JustinVerkade/KiCadLibraryProcessor/BOM_Processor/20240322-Electrical component library.xlsx

Document: | Electrical component library
Last changed: | 2024-03-23
Author: | Justin Verkade
Type | Manufacturer number | Manufacturer | Footprint | Val1 | Val2 | Val3 | Val4 | Val5 | Val6 | Costs | Url
Resistor | CRCW04022K20JNED | Vishay / Dale | 0402 | 2.2k | 5% | 50V | 62.5mW |  |  | €0.09 | https://nl.mouser.com/ProductDetail/Vishay-Dale/CRCW04022K20JNED?qs=hD42E%2F8yzjr994JNQ8Enjw%3D%3D
Capacitor | 04026C104KAT2A | KYOCERA AVX | 0402 | 100n | 10% | 6.3V |  |  |  | €0.09 | https://nl.mouser.com/ProductDetail/KYOCERA-AVX/04026C104KAT2A?qs=Q0wCMCRSJ1vLqipDGm0h%252BA%3D%3D
Microcontroller | STM32F072CBT6 | STMicroelectronics | LQFP-48 | 48Mhz | 128kB | 16kB |  |  |  | €4.19 | https://nl.mouser.com/ProductDetail/STMicroelectronics/STM32F072CBT6?qs=xf9JV0PLFEfBqXx8wKtR8A%3D%3D
Motor driver | TMC6300-LA | Trinamics ADI | QFN-20 | BLDC | 2A | 11V |  |  |  | €2.26 | https://nl.mouser.com/ProductDetail/ADI-Trinamic/TMC6300-LA-T?qs=TiOZkKH1s2SPDan6zA6fKg%3D%3D
Microcontroller | STM32L431KBU6 | STMicroelectronics | UFQFPN-32 | 80Mhz | 128kB | 64kB |  |  |  | €4.56 | https://nl.mouser.com/ProductDetail/STMicroelectronics/STM32L431KBU6?qs=U58vgkJzipSSkpDs8ltE9g%3D%3D
ESD/TVS diode | SZESD8351P2T5G | Onsemi | SOD-923-2 | 3.3V |  |  |  |  |  | €0.36 | https://nl.mouser.com/ProductDetail/onsemi/SZESD8351P2T5G?qs=dbuNSGnowt0hk7yUFmffJA%3D%3D
LED | 150060AS75000 | Wurth Electronik | 0603 | Amber | 30mA | 2V |  |  |  | €0.14 | https://nl.mouser.com/ProductDetail/Wurth-Elektronik/150060AS75000?qs=d0WKAl%252BL4KbvMBYryeof0Q%3D%3D
ESD/TVS diode | ESD9X12ST5G | Onsemi | SOD-923-2 | 12V |  |  |  |  |  | €0.20 | https://nl.mouser.com/ProductDetail/onsemi/ESD9X12ST5G?qs=OSf9jACorvYeEtLjAfCdrQ%3D%3D
Buck converter | MP1479GTF-Z | MPS | SOT-563-6 | 800mV-10V | 1A | 18V |  |  |  | €0.90 | https://nl.mouser.com/ProductDetail/Monolithic-Power-Systems-MPS/MP1479GTF-Z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
Connector | B8B-PH-K-S_LF__SN_ | JST | - | 8-pin | 2mm | 3A |  |  |  | €0.40 | https://nl.rs-online.com/web/p/pcb-headers/8201444
Connector | B3B-PH-K-S_LF__SN_ | JST | - | 3-pin | 2mm | 3A |  |  |  | €0.05 | https://nl.rs-online.com/web/p/pcb-headers/8201431
Connector | B2B-PH-K-S_LF__SN_ | JST | - | 2-pin | 2mm | 3A |  |  |  | €0.16 | https://nl.rs-online.com/web/p/pcb-headers/8201422
Resistor | ERJ-6DSFR12V | Panasonic | 0805 | 120m | 1% |  | 500mW |  |  | €0.42 | https://nl.mouser.com/ProductDetail/Panasonic/ERJ-6DSFR12V?qs=WO7YBshssFF0LlAZA3Tj0Q%3D%3D
Ferrite bead | BLM15AX102SZ1D | Murata Electronics | 0402 | 1k | 25% | 350mA |  |  |  | €0.09 | https://nl.mouser.com/ProductDetail/Murata-Electronics/BLM15AX102SZ1D?qs=lEfY3O89Aqnho9IqRYLNSw%3D%3D
Connector | 20021121-00006T4LF | Amphenol FCI | - | 6-pin | 1.27mm | 1A |  |  |  | €0.57 | https://nl.mouser.com/ProductDetail/Amphenol-FCI/20021121-00006T4LF?qs=oJs1R%252BxK6kTRYpFukouk8Q%3D%3D
Opamp | TLV8541DBVR | Texas Instruments | SOT-23-5 | 3.6V |  |  |  |  |  | €0.84 | https://nl.mouser.com/ProductDetail/Texas-Instruments/TLV8541DBVR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
Inductor | VLS3015CX-4R7M-1 | TDK | 3x3x1.5mm | 4.7u | 1.52A |  |  |  |  | €0.31 | https://nl.mouser.com/ProductDetail/TDK/VLS3015CX-4R7M-1?qs=gZXFycFWdANzf31QH9GBWA%3D%3D
ESD/TVS diode | PTVS12VS1UR,115 | Nexperia | SOD-123-2 | 12V |  |  |  |  |  | €0.35 | https://nl.mouser.com/ProductDetail/Nexperia/PTVS12VS1UR115?qs=LMSg3oBIm%2FiWSHvsyxWiLg%3D%3D
ESD/TVS diode | SZESD9101P2T5G | Onsemi | SOD-923-2 | 5V |  |  |  |  |  | €0.43 | https://nl.mouser.com/ProductDetail/onsemi/SZESD9101P2T5G?qs=5aG0NVq1C4yTUV3vL3eSQg%3D%3D
Capacitor | C1005X7R1C104K050BC | TDK | 0402 | 100n | 10% | 12V |  |  |  | €0.09 | https://nl.mouser.com/ProductDetail/TDK/C1005X7R1C104K050BC?qs=NRhsANhppD%252BhAGOapA8QKQ%3D%3D
Capacitor | CL21A226MAYNNNE | Samsung Electro-Mechanics | 0805 | 22u | 20% | 25V |  |  |  | €0.23 | https://nl.mouser.com/ProductDetail/Samsung-Electro-Mechanics/CL21A226MAYNNNE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
Capacitor | TMK107BJ105KA-T | TAIYO YUDEN | 0603 | 1u | 10% | 25V |  |  |  | €0.09 | https://nl.mouser.com/ProductDetail/TAIYO-YUDEN/TMK107BJ105KA-T?qs=PzICbMaShUeN5muIUMy52A%3D%3D
Capacitor | GRM21BC71E106KE01K | Murata Electronics | 0805 | 10u | 10% | 25V |  |  |  | €0.34 | https://nl.mouser.com/ProductDetail/Murata-Electronics/GRM21BC71E106KE01K?qs=By6Nw2ByBD2m3JOqf4AY1Q%3D%3D
Capacitor | CL10A225KO8NNNC | Samsung Electro-Mechanics | 0603 | 2.2u | 10% | 16V |  |  |  | €0.09 | https://nl.mouser.com/ProductDetail/Samsung-Electro-Mechanics/CL10A225KO8NNNC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
Capacitor | GRM155C81E105KE11J | Murata Electronics | 0402 | 1u | 10% | 25V |  |  |  | €0.09 | https://nl.mouser.com/ProductDetail/Murata-Electronics/GRM155C81E105KE11J?qs=hNud%2FORuBR0msnbqee6%2FPw%3D%3D
Resistor | AF0402JR-07220RL | YAGEO | 0402 | 220 | 5% | 50V | 62.5mW |  |  | €0.09 | https://nl.mouser.com/ProductDetail/YAGEO/AF0402JR-07220RL?qs=Ghq3E7L6HNfV8BjGdjwaqw%3D%3D
Resistor | RC0402FR-072K2P | YAGEO | 0402 | 2.2k | 1% | 50V | 62.5mW |  |  | €0.09 | https://nl.mouser.com/ProductDetail/YAGEO/RC0402FR-072K2P?qs=oypCK0zG3263%2FFJJTa4fIg%3D%3D
Resistor | RC0402FR-7D100KL | YAGEO | 0402 | 100k | 1% | 50V | 62.5mW |  |  | €0.09 | https://nl.mouser.com/ProductDetail/YAGEO/RC0402FR-7D100KL?qs=F5EMLAvA7IBe5AeajP0LKQ%3D%3D
Resistor | RC0402FR-0713KL | YAGEO | 0402 | 13k | 1% | 50V | 62.5mW |  |  | €0.09 | https://nl.mouser.com/ProductDetail/YAGEO/RC0402FR-0713KL?qs=sxZXDnvRBEhPjc%252B9C6HVrA%3D%3D
Resistor | RC0402FR-0740K2L | YAGEO | 0402 | 40.2k | 1% | 50V | 62.5mW |  |  | €0.09 | https://nl.mouser.com/ProductDetail/YAGEO/RC0402FR-0740K2L?qs=UOUeRUa%252B8Wn56bwc3oChog%3D%3D
Resistor | RC0402FR-077K68L | YAGEO | 0402 | 7.68k | 1% | 50V | 62.5mW |  |  | €0.09 | https://nl.mouser.com/ProductDetail/YAGEO/RC0402FR-077K68L?qs=Is6ZsIPfHkasmjGY7J9QlA%3D%3D
Resistor | AC0402FR-7W47KL | YAGEO | 0402 | 47k | 1% | 50V | 125mW |  |  | €0.09 | https://nl.mouser.com/ProductDetail/YAGEO/AC0402FR-7W47KL?qs=mQk0km4IMDeu%252BLYkO5whnw%3D%3D
Resistor | RC0402JR-0710RP | YAGEO | 0402 | 10 | 5% | 50V | 62.5mW |  |  | €0.09 | https://nl.mouser.com/ProductDetail/YAGEO/RC0402JR-0710RP?qs=oypCK0zG324s%252BbbL7ccvUA%3D%3D
Resistor | RT0402FRE07649RL | YAGEO | 0402 | 649 | 1% | 50V | 62.5mW |  |  | €0.11 | https://nl.mouser.com/ProductDetail/YAGEO/RT0402FRE07649RL?qs=sGAEpiMZZMvdGkrng054t98Xz4DA4UW4bL7f7IZrCXc%3D
Resistor | ERJ-2RKF2702X | Panasonic | 0402 | 27k | 1% | 50V | 100mW |  |  | €0.09 | https://nl.mouser.com/ProductDetail/Panasonic/ERJ-2RKF2702X?qs=YMBIwoNQYdVjy3UL%2FjeFIg%3D%3D
Capacitor | C0603C225K9PAC | KEMET | 0603 | 2.2u | 10% | 6.3V |  |  |  | €0.09 | https://nl.mouser.com/ProductDetail/KEMET/C0603C225K9PAC?qs=AHS6Mz2dKxMbzMnN5xHEwA%3D%3D
LED | 150060SS55040 | Wurth Electronik | 0603 | Super Red | 20mA | 2V |  |  |  | €0.18 | https://nl.mouser.com/ProductDetail/Wurth-Elektronik/150060SS55040?qs=8Aam6%252B7C6HG0AGgMR5PhFg%3D%3D
LED | 150060VS55040 | Wurth Electronik | 0603 | Green | 20mA | 2V |  |  |  | €0.18 | https://nl.mouser.com/ProductDetail/Wurth-Elektronik/150060VS55040?qs=8Aam6%252B7C6HEumg%252B0cJZzvA%3D%3D
Capacitor | 04026A100JAT2A | KYOCERA AVX | 0402 | 10p | 5% | 6.3V |  |  |  | €0.24 | https://nl.mouser.com/ProductDetail/KYOCERA-AVX/04026A100JAT2A?qs=XLNwXgtzMM%2Fx5CgSRtM7uA%3D%3D
Connector | 284512-3 | TE Connectivity | - | 3-pin | 3.5mm | 11A |  |  |  | €1.15 | https://nl.mouser.com/ProductDetail/TE-Connectivity/284512-3?qs=woBvfblj%2Fzwah7g8QvojCQ%3D%3D
Ferrite bead | MMZ2012D121BTD25 | TDK | 0805 | 120 | 25% | 500mA |  |  |  | €0.10 | https://nl.mouser.com/ProductDetail/TDK/MMZ2012D121BTD25?qs=pvNC7ksEVIfZfSRHo03SKw%3D%3D
ESD/TVS diode | PESD2USB3UVT-QR | Nexperia | SOT-23-3 | 3.3V |  |  |  |  |  | €0.35 | https://nl.mouser.com/ProductDetail/Nexperia/PESD2USB3UVT-QR?qs=3Rah4i%252BhyCFPJOQFghMZ%252BQ%3D%3D
Resistor | AF0402FR-07120RL | YAGEO | 0402 | 120 | 1% | 50V | 62.5mW |  |  | €0.09 | https://nl.mouser.com/ProductDetail/YAGEO/AF0402FR-07120RL?qs=tggtontpCXNqJs0%252BaiMQVA%3D%3D
Resistor | AC0402JR-7W1KL | YAGEO | 0402 | 1k | 5% | 50V | 125mW |  |  | €0.09 | https://nl.mouser.com/ProductDetail/YAGEO/AC0402JR-7W1KL?qs=j%252B1pi9TdxUZ8VnEUd7zFaA%3D%3D
ESD/TVS diode | PEC33712C2AR1000 | Panjit | SOT-23-3 | 12V/-7V |  |  |  |  |  | €0.33 | https://nl.mouser.com/ProductDetail/Panjit/PEC33712C2A_R1_00001?qs=sPbYRqrBIVk%252Bwt1QuorMhw%3D%3D
Eeprom | AT24C02D-STUM-T | Microchip Technology | SOT-23-5 | 2kBit | I2C | 3.6V |  |  |  | €0.19 | https://nl.mouser.com/ProductDetail/Microchip-Technology/AT24C02D-STUM-T?qs=l5F7KFZg3O4Jn%2FWWCVhgNg%3D%3D
Capacitor | GRT155R71C104KE01J | Murata Electronics | 0402 | 100n | 10% | 16V |  |  |  | €0.09 | https://nl.mouser.com/ProductDetail/Murata-Electronics/GRT155R71C104KE01J?qs=RcG8xmE7yp2lWPzmRVbOdg%3D%3D
Resistor | CRCW040210K0JNEDC | Vishay / Dale | 0402 | 10k | 5% | 50V | 62.5mW |  |  | €0.09 | https://nl.mouser.com/ProductDetail/Vishay-Dale/CRCW040210K0JNEDC?qs=E3Y5ESvWgWMUjeDciQkbxw%3D%3D
Capacitor | 865230543003 | Wurth Electronik | ALU | 22u | 20% | 35V |  |  |  | €0.27 | https://nl.mouser.com/ProductDetail/Wurth-Elektronik/865230543003?qs=0KOYDY2FL29wTbOMyWRiVg%3D%3D
Resistor | RC0402FR-7D22RL | YAGEO | 0402 | 22 | 1% | 50V | 62.5mW |  |  | €0.09 | https://nl.mouser.com/ProductDetail/YAGEO/RC0402FR-7D22RL?qs=F5EMLAvA7ICmyszJ%252B2F6BQ%3D%3D
Resistor | CR0402-JW-470GLF | Bourns | 0402 | 47 | 5% | 50V | 62.5mW |  |  | €0.09 | https://nl.mouser.com/ProductDetail/Bourns/CR0402-JW-470GLF?qs=SUIU1o4JoRquVq%252BbfEL1Yg%3D%3D
Capacitor | CL10A105KO8NNWC | Samsung Electro-Mechanics | 0603 | 1u | 10% | 16V |  |  |  | €0.09 | https://nl.mouser.com/ProductDetail/Samsung-Electro-Mechanics/CL10A105KO8NNWC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
Fuse | 1206L025YR | Littlefuse | 1206 | 250mA | 16V |  |  |  |  | €0.45 | https://nl.mouser.com/ProductDetail/Littelfuse/1206L025YR?qs=PWhpLWeW8wedgRREX8zxcg%3D%3D
Crystal | ECS-160-7-33B-CKL-TR | ECS | 3.2x2.5mm | 16Mhz | 7pF |  |  |  |  | €0.49 | https://nl.mouser.com/ProductDetail/ECS/ECS-160-7-33B-CKL-TR?qs=wd5RIQLrsJhEy%252BtlnvJYvQ%3D%3D
ESD/TVS diode | ESDA051-1JY | STMicroelectronics | SOD-323-2 | 5V |  |  |  |  |  | €0.31 | https://nl.mouser.com/ProductDetail/STMicroelectronics/ESDA051-1JY?qs=GBLSl2Akirsi1Hb6Zv2f8w%3D%3D
Transceiver | ATA6561-GAQW-N | Microchip Technology | SOIC-8 | CAN |  |  |  |  |  | €0.45 | https://nl.mouser.com/ProductDetail/Microchip-Technology/ATA6561-GAQW-N?qs=y6ZabgHbY%252BwGbm2JCZMHKQ%3D%3D
Connector | UJ2-BH-2-TH | CUI Devices | - | USB-B |  |  |  |  |  | €0.58 | https://nl.mouser.com/ProductDetail/CUI-Devices/UJ2-BH-2-TH?qs=5mqXD9RfOg268ck27dussA%3D%3D
Linear regulator | ADP122ACPZ-3.3-R7 | Analog Devices | LFCSP-6 | 3.3V | 300mA | 5.5V |  |  |  | €1.37 | https://nl.mouser.com/ProductDetail/Analog-Devices/ADP122ACPZ-3.3-R7?qs=BpaRKvA4VqFGxcUJVezYbA%3D%3D
ESD/TVS diode | PESD2USB3UVT-QR | Nexperia | SOT-23-3 | 3.3V |  |  |  |  |  | €0.35 | https://nl.mouser.com/ProductDetail/Nexperia/PESD2USB3UVT-QR?qs=3Rah4i%252BhyCFPJOQFghMZ%252BQ%3D%3D
Transceiver | ST3485EBDR | STMicroelectronics | SOIC-8 | RS485 |  |  |  |  |  | €1.45 | https://nl.mouser.com/ProductDetail/STMicroelectronics/ST3485EBDR?qs=QRFxM3C6KJHTwCRHyIiZWQ%3D%3D
LED | CLY6D-FKC-CK1N1D1BB7D3D3 | Cree LED | PLCC-6 | RGB | 10mA | 3V |  |  |  | €0.41 | https://eu.mouser.com/ProductDetail/Cree-LED/CLY6D-FKC-CK1N1D1BB7D3D3?qs=3ZbGupGMFUcwV8ee%2FC0TnQ%3D%3D
LED | 150060GS75000 | Wurth Electronik | 0603 | Green | 20mA | 3.2V |  |  |  | €0.14 | https://eu.mouser.com/ProductDetail/Wurth-Elektronik/150060GS75000?qs=LlUlMxKIyB0UYkq5lDO8nA%3D%3D
Zener diode | BZT52C5V6-TP | MCC | SOD-123-2 | 5.6V |  |  |  |  |  | €0.10 | https://nl.mouser.com/ProductDetail/Micro-Commercial-Components-MCC/BZT52C5V6-TP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
Crystal | ECS-80-8-33B2Q-CVY-TR3 | ECS | 3.2x2.5mm | 8Mhz | 8pF |  |  |  |  | €0.51 | https://nl.mouser.com/ProductDetail/ECS/ECS-80-8-33B2Q-CVY-TR3?qs=dbcCsuKDzFVl0H%252BeEfWd9g%3D%3D
Resistor | AC0402FR-0788K7L | YAGEO | 0402 | 88.7k | 1% | 50V | 62.5mW |  |  | €0.10 | https://nl.mouser.com/ProductDetail/YAGEO/AC0402FR-0788K7L?qs=UBLIud9aIG2CqTllOErnqg%3D%3D
Resistor | AC0402FR-0722K1L | YAGEO | 0402 | 22.1k | 1% | 50V | 62.5mW |  |  | €0.10 | https://nl.mouser.com/ProductDetail/YAGEO/AC0402FR-0722K1L?qs=UBLIud9aIG1Jf9OUfe%252BKIg%3D%3D
Transistor | NSS30101LT1G | Onsemi | SOT-23-3 | 1A | 30V |  |  |  |  | €0.37 | https://nl.mouser.com/ProductDetail/onsemi/NSS30101LT1G?qs=ZXBb0xZ9WeA7Sk469FceMw%3D%3D
Buzzer | PKLCS1212E2400-R1 | Murata Electronics | 12x12x3mm | 25V | 70dB |  |  |  |  | €1.24 | https://nl.mouser.com/ProductDetail/Murata-Electronics/PKLCS1212E2400-R1?qs=RHTUnHIbtSpfSWhyGRGggw%3D%3D
Inductor | IFSC1616AHER4R7M01 | Vishay / Dale | 1616 | 4.7u | 2.2A |  |  |  |  | €0.30 | https://nl.mouser.com/ProductDetail/Vishay-Dale/IFSC1616AHER4R7M01?qs=iLKYxzqNS74VpDZQPPzmDg%3D%3D
Inductor | MLZ2012N4R7LT000 | TDK | 0805 | 4.7u | 600mA |  |  |  |  | €0.10 | https://nl.mouser.com/ProductDetail/TDK/MLZ2012N4R7LT000?qs=%2FPzWLGNeQ%252BiQC4rpbxkNLA%3D%3D
Connector | 951103-8622-AR | 3M | - | 3-pin | 2.54mm | 2A |  |  |  | €0.49 | https://nl.mouser.com/ProductDetail/3M-Electronic-Solutions-Division/951103-8622-AR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
Linear regulator | TLV1117LV33DCYR | Texas Instruments | SOT-223-4 | 3.3V | 1A | 5.5V |  |  |  | €0.21 | https://nl.mouser.com/ProductDetail/Texas-Instruments/TLV1117LV33DCYR?qs=tEz3BkPb1rwzXMb8FiWhow%3D%3D
Buck converter | LMR50410Y5FQDBVRQ1 | Texas Instruments | SOT-23-6 | 5V | 1A | 36V |  |  |  | €1.68 | https://nl.mouser.com/ProductDetail/Texas-Instruments/LMR50410Y5FQDBVRQ1?qs=81r%252BiQLm7BR57cLsTbTr9w%3D%3D
IMU | LSM6DS3TR-C | STMicroelectronics | LGA-14L | 6-axis | 16-bit | SPI |  |  |  | €6.54 | https://nl.mouser.com/ProductDetail/STMicroelectronics/LSM6DS3TR-C?qs=u4fy%2FsgLU9NHwPlhP3LTBw%3D%3D
Fuse | SF-0603SP050-2 | Bourns | 0603 | 500mA | 50V |  |  |  |  | €0.61 | https://nl.mouser.com/ProductDetail/Bourns/SF-0603SP050-2?qs=pxDZlBjcsCiZ7zu1RXtEkQ%3D%3D
ESD/TVS diode | PTVS13VS1UR-QX | Nexperia | SOD-123W-2 | 13V |  |  |  |  |  | €0.38 | https://nl.mouser.com/ProductDetail/Nexperia/PTVS13VS1UR-QX?qs=vvQtp7zwQdPucLbaKt9qmg%3D%3D
Capacitor | CL10A475KO8NNNC | Samsung Electro-Mechanics | 0603 | 4.7u | 10% | 16V |  |  |  | €0.10 | https://nl.mouser.com/ProductDetail/Samsung-Electro-Mechanics/CL10A475KO8NNNC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
Capacitor | 865080442004 | Wurth Electronik | ALU | 22u | 20% | 25V |  |  |  | €0.19 | https://nl.mouser.com/ProductDetail/Wurth-Elektronik/865080442004?qs=0KOYDY2FL2%2FMog8otpzhrw%3D%3D
Capacitor | CL10X106MO8NRNC | Samsung Electro-Mechanics | 0603 | 10u | 20% | 16V |  |  |  | €0.18 | https://nl.mouser.com/ProductDetail/Samsung-Electro-Mechanics/CL10X106MO8NRNC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
Connector | M20-9990645 | Harwin | - | 6-pin | 2.54mm | 2A |  |  |  | €0.27 | https://nl.mouser.com/ProductDetail/Harwin/M20-9990645?qs=Jph8NoUxIfWe7BJQOhiVRg%3D%3D
ESD/TVS diode | ESD5Z3.3T5G | Onsemi | SOD-523-2 | 3.3V |  |  |  |  |  | €0.11 | https://nl.mouser.com/ProductDetail/onsemi/ESD5Z3.3T5G?qs=tCMd4XlZ%2FiC1HG%2Fi9P8V3A%3D%3D
Choke | SRF4532-110Y | Bourns | 4532 | 11u | 300mA |  |  |  |  | €0.61 | https://nl.mouser.com/ProductDetail/Bourns/SRF4532-110Y?qs=u649AIwumF8o5t6hcAfmlw%3D%3D
Mosfet | DMN63D8L-7 | Diodes incorporated | SOT-23-3 | 350mA | 30V |  |  |  |  | €0.10 | https://nl.mouser.com/ProductDetail/Diodes-Incorporated/DMN63D8L-7?qs=d6FSPxoZCrGOEU7aEm7SGw%3D%3D
ESD/TVS diode | PESD2USB3UV-TR | Nexperia | SOT-23-3 | 3.3V |  |  |  |  |  | €0.27 | https://nl.mouser.com/ProductDetail/Nexperia/PESD2USB3UV-TR?qs=sPbYRqrBIVktfNGXEmMY8w%3D%3D
Connector | UJ2-BH-W1-TH | Same Sky | - | USB-B |  |  |  |  |  | €0.39 | https://nl.mouser.com/ProductDetail/Same-Sky/UJ2-BH-W1-TH?qs=5mqXD9RfOg3dpHLjDScu%2Fg%3D%3D
Jumper | SNT-100-BK-G | Samtec | - | 2-pin | 2.54mm |  |  |  |  | €0.29 | https://nl.mouser.com/c/?q=SNT-100-BK-G
Resistor | CR0402-FX-3302GLF | Bourns | 0402 | 33k | 1% | 50V | 62.5mW |  |  | €0.10 | https://nl.mouser.com/ProductDetail/Bourns/CR0402-FX-3302GLF?qs=SFHnMgm9Isze0zS5GpsQzw%3D%3D
Choke | BWCU00321619102M02 | Pulse Electronics | - | 1kOhm | 230mA |  |  |  |  | €0.26 | https://nl.mouser.com/ProductDetail/Pulse-Electronics/BWCU00321619102M02?qs=rSMjJ%252B1ewcTzWn5h5I2VvQ%3D%3D
Microcontroller | STM32F446RET6 | STMicroelectronics | LQFP-64 | 180Mhz | 512kB | 128kB |  |  |  | €8.41 | https://nl.mouser.com/ProductDetail/STMicroelectronics/STM32F446RET6?qs=Ok1pvOkw6%2FqpQsWf8F4wtQ%3D%3D
Eeprom | AT24CSW040-STUM-T | Microchip Technology | TSOT-23-5 | 4kBit | I2C | 3.6V |  |  |  | €0.20 | https://nl.mouser.com/ProductDetail/Microchip-Technology/AT24CSW040-STUM-T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
Capacitor | 865090449009 | Wurth Electronik | ALU | 100u | 20% | 25V |  |  |  | €0.47 | https://nl.mouser.com/ProductDetail/Wurth-Elektronik/865090449009?qs=0KOYDY2FL29%2F%2FAkRd1dwYw%3D%3D
Inductor | SRP7028CC-100M | Bourns | 2826 | 10u | 3.5A |  |  |  |  | €0.60 | https://nl.mouser.com/ProductDetail/Bourns/SRP7028CC-100M?qs=1Kr7Jg1SGW%252BFrchEKUd2WQ%3D%3D
Capacitor | EEV227M016S9MAA | KEMET | ALU | 220u | 20% | 16V |  |  |  | €0.72 | https://nl.mouser.com/ProductDetail/KEMET/EEV227M016S9MAA?qs=E9QF1UCAUX6A%2FKIXnek8Qw%3D%3D
Inductor | SRN6045-2R2Y | Bourns | 6x6mm | 2.2u | 3.5A |  |  |  |  | €0.40 | https://nl.mouser.com/ProductDetail/Bourns/SRN6045-2R2Y?qs=opBjA1TV903BwygMAGUj4g%3D%3D
Connector | S2B-PH-SM4-TB_LF__SN_ | JST | - | 2-pin | 2mm | 3A |  |  |  | €0.48 | https://nl.mouser.com/ProductDetail/JST-Commercial/S2B-PH-SM4-TBLFSN?qs=QpmGXVUTftGPIOdg%2F2bstg%3D%3D
Capacitor | C0402C470G3HACAUTO | KEMET | 0402 | 47p | 2% | 25V |  |  |  | €0.10 | https://nl.mouser.com/ProductDetail/KEMET/C0402C470G3HACAUTO?qs=j%252B1pi9TdxUbG7c6omsNkMA%3D%3D
Buck converter | RT6274CHGJ6F | Richtek | TSOT-23-6 | 765mV-7V | 3.5A | 18V |  |  |  | €0.83 | https://nl.mouser.com/ProductDetail/Richtek/RT6274CHGJ6F?qs=amGC7iS6iy%2FOraG%2FNjNFhQ%3D%3D
Resistor | CRCW040268K0FKED | Vishay / Dale | 0402 | 68k | 1% | 50V | 62.5mW |  |  | €0.10 | https://nl.mouser.com/ProductDetail/Vishay-Dale/CRCW040268K0FKED?qs=DKbL89i6OEpie2mAVmMSTw%3D%3D
ESD/TVS diode | ESDA18-1K | STMicroelectronics | SOD-523-2 | 15V |  |  |  |  |  | €0.30 | https://nl.mouser.com/ProductDetail/STMicroelectronics/ESDA18-1K?qs=raAh8RbVwI7pG6%2FatW9xFg%3D%3D
ESD/TVS diode | SMAJ6.0A-13-F | Diodes incorporated | SMA-2 | 6V |  |  |  |  |  | €0.35 | https://nl.mouser.com/ProductDetail/Diodes-Incorporated/SMAJ6.0A-13-F?qs=gaDBXWSqsDBS%252B5NeClx%252BYA%3D%3D
Fuse | ERB-RE2R00V | Panasonic | 0603 | 2A | 32V |  |  |  |  | €0.25 | https://nl.mouser.com/ProductDetail/Panasonic/ERB-RE2R00V?qs=YIEcsSB2Lz7FNCZyYhOhwA%3D%3D
Inductor | SRR5228A-100M | Bourns | 5.2x5.2x2.8mm | 10u | 2.3A |  |  |  |  | €0.98 | https://nl.mouser.com/ProductDetail/Bourns/SRR5228A-100M?qs=QpmGXVUTftHeuNKRp2sSEw%3D%3D
Resistor | CRCW040212K0FKED | Vishay / Dale | 0402 | 12k | 1% | 50V | 62.5mW |  |  | €0.10 | https://nl.mouser.com/ProductDetail/Vishay-Dale/CRCW040212K0FKED?qs=8wskyPz2qw0TSO6PD5q8Nw%3D%3D
Connector | M20-7832046 | Harwin | - | 2x20-pin | 2.54mm | 2A |  |  |  | €3.50 | https://nl.mouser.com/ProductDetail/Harwin/M20-7832046?qs=93uzuGORGqcTOAy6u%252BlWXQ%3D%3D
Capacitor | TMK105BJ104KV | TAIYO YUDEN | 0402 | 100n | 10% | 25V |  |  |  | €0.10 | https://nl.mouser.com/ProductDetail/TAIYO-YUDEN/TMK105BJ104KV-F?qs=PzICbMaShUcuRhf9Ji%2F5mA%3D%3D
Fuse | 0407006.WR | Littlefuse | 1206 | 6A | 24V |  |  |  |  | €0.49 | https://nl.mouser.com/ProductDetail/Littelfuse/0407006.WR?qs=sPbYRqrBIVmH0oD7q%252BOKfw%3D%3D
Fuse | SF-1206HH20M-2 | Bourns | 1206 | 20A | 24V |  |  |  |  | €0.57 | https://nl.mouser.com/ProductDetail/Bourns/SF-1206HH20M-2?qs=gTYE2QTfZfSIcL5c8oAFag%3D%3D
Capacitor | GCM1555C1H8R0DA16D | Murata Electronics | 0402 | 8p | 5% | 50V |  |  |  | €0.10 | https://nl.mouser.com/ProductDetail/Murata-Electronics/GCM1555C1H8R0DA16D?qs=ui%252B2d9lVEI56SuLlbLRhpw%3D%3D
Mosfet | RUM001L02T2CL | ROHM Semiconductor | SOT-723-3 | 100mA | 20V |  |  |  |  | €0.28 | https://nl.mouser.com/ProductDetail/ROHM-Semiconductor/RUM001L02T2CL?qs=QcFhgjUTvvq561FHtbVAHA%3D%3D
ESD/TVS diode | SM15T15A | STMicroelectronics | DO-214AB-2 | 12.8V |  |  |  |  |  | €0.39 | https://nl.mouser.com/ProductDetail/STMicroelectronics/SM15T15A?qs=NT9noNhSp6fKGZXAPqXGSQ%3D%3D
Resistor | CSNL1206FT20L0 | SEI Stackpole | 1206 | 20m | 1% | 50V | 1W |  |  | €0.58 | https://nl.mouser.com/ProductDetail/SEI-Stackpole/CSNL1206FT20L0?qs=IPgv5n7u5QYaSwXRSMXcSA%3D%3D
Mosfet | TSM080N03EPQ56_RLG | Taiwan semiconductor | PDFN-56-8 | 55A | 30V |  |  |  |  | €0.25 | https://nl.mouser.com/ProductDetail/Taiwan-Semiconductor/TSM080N03EPQ56-RLG?qs=5aG0NVq1C4yp2zSLivBAhw%3D%3D
Inductor | MLZ1608A2R2MT | TDK | 0603 | 2.2u | 500mA |  |  |  |  | €0.11 | https://nl.mouser.com/ProductDetail/TDK/MLZ1608A2R2MT?qs=chjFIDm9dboKeT4jRGqjSw%3D%3D
Microcontroller | STM32G0B1CBT3 | STMicroelectronics | LQFP-48 | 64Mhz | 129kB | 144kB |  |  |  | €5.00 | https://nl.mouser.com/ProductDetail/STMicroelectronics/STM32G0B1CBT3?qs=Jm2GQyTW%2FbiDRW500iRxHQ%3D%3D
Connector | 39-30-6087 | Molex | - | 2x4-pin | 4.2mm | 9A |  |  |  | €1.23 | https://nl.mouser.com/ProductDetail/Molex/39-30-6087?qs=cm0cgiBciNbas9C0adTFzQ%3D%3D
Capacitor | GRM155R71H223KA12D | Murata Electronics | 0402 | 22n | 10% | 50V |  |  |  | €0.10 | https://nl.mouser.com/ProductDetail/Murata-Electronics/GRM155R71H223KA12D?qs=Dfh4SrgScWyE65FKEkixtw%3D%3D
Capacitor | 0402YA8R0DAT2A | KYOCERA AVX | 0402 | 8p | 0.5p | 16V |  |  |  | €0.22 | https://nl.mouser.com/ProductDetail/KYOCERA-AVX/0402YA8R0DAT2A?qs=cnDM9bjyeUgb33j4CSRbcA%3D%3D
Capacitor | GRT188C81E475KE13D | Murata Electronics | 0603 | 4.7u | 10% | 25V |  |  |  | €0.15 | https://nl.mouser.com/ProductDetail/Murata-Electronics/GRT188C81E475KE13D?qs=drgMNd%252BkGPMKgxVy0k4hkQ%3D%3D
Fuse | 0679L8000-05 | Bel Fuse | 2410 | 8A | 125V |  |  |  |  | €0.26 | https://nl.mouser.com/ProductDetail/Bel-Fuse/0679L8000-05?qs=ZqXcJfGlKsiv8iEKvn6xcw%3D%3D
Inductor | IHLP3232DZER4R7M11 | Vishay / Dale | 3232 | 4.7u | 8A |  |  |  |  | €1.07 | https://nl.mouser.com/ProductDetail/Vishay-Dale/IHLP3232DZER4R7M11?qs=Nbmv7C3%2FzlBkjG9ees3Knw%3D%3D
Resistor | AF0402JR-072R2L | YAGEO | 0402 | 2.2 | 5% | 50V | 62.5mW |  |  | €0.10 | https://nl.mouser.com/ProductDetail/YAGEO/AF0402JR-072R2L?qs=tggtontpCXPmK9zDAYOzgw%3D%3D
Capacitor | EEE-FT1H331AP | Panasonic | ALU | 330u | 20% | 50V |  |  |  | €1.05 | https://nl.mouser.com/ProductDetail/Panasonic/EEE-FT1H331AP?qs=CMJjuEs1%252BuFKH1%2FdyV0DMg%3D%3D
ESD/TVS diode | ESD9P5.0ST5G | Onsemi | SOD-923-2 | 5V |  |  |  |  |  | €0.12 | https://nl.mouser.com/ProductDetail/onsemi/ESD9P5.0ST5G?qs=b5%252BO11yZ0ajVekAdu65x%252BA%3D%3D
Capacitor | C1005X5R1H222M050BA | TDK | 0402 | 2.2n | 20% | 50V |  |  |  | €0.10 | https://nl.mouser.com/ProductDetail/TDK/C1005X5R1H222M050BA?qs=xLDY6iXSiQatLyIoAnJIPg%3D%3D
Motor driver | TMC6200-TA | Trinamics ADI | TQFP-48 | BLDC | - | 60V |  |  |  | €5.97 | https://nl.mouser.com/ProductDetail/ADI-Trinamic/TMC6200-TA?qs=TiOZkKH1s2S63bdxD7r%252BIw%3D%3D
Capacitor | CL31B475KAHNNNE | Samsung Electro-Mechanics | 1206 | 4.7u | 10% | 25V |  |  |  | €0.14 | https://nl.mouser.com/ProductDetail/Samsung-Electro-Mechanics/CL31B475KAHNNNE?qs=349EhDEZ59oSE8dT4yS8Ow%3D%3D
Comparator | LM339LVPWR | Texas Instruments | TSSOP-14 | 5.5V | 4-channel |  |  |  |  | €0.26 | https://nl.mouser.com/ProductDetail/Texas-Instruments/LM339LVPWR?qs=QNEnbhJQKvZwu88lvYobUw%3D%3D
Opamp | LM321LVIDCKR | Texas Instruments | SC-70-5 | 5.5V |  |  |  |  |  | €0.10 | https://nl.mouser.com/ProductDetail/Texas-Instruments/LM321LVIDCKR?qs=qSfuJ%252Bfl%2Fd6RcyTOjkRx5Q%3D%3D
Button | PTS636_SL50_SMTR_LFS | C&K | - | NO |  |  |  |  |  | €0.18 | https://nl.mouser.com/ProductDetail/CK/PTS636-SL50-SMTR-LFS?qs=vLWxofP3U2zRoRV76Po6zQ%3D%3D
LED | WP7113ID | Kingbright | 5mm | Red | 10mA | 1.9V |  |  |  | €0.28 | https://nl.mouser.com/ProductDetail/Kingbright/WP7113ID?qs=hyavMCx%252BcmDJhCThgY7pfQ%3D%3D
Ferrite bead | BLM18KG101TN1D | Murata Electronics | 0603 | 100 | 25% | 3A |  |  |  | €0.10 | https://nl.mouser.com/ProductDetail/Murata-Electronics/BLM18KG101TN1D?qs=MY6wChARw2zdno9LTSL6Ng%3D%3D
Resistor | CAY16-681J4LF | Bourns | 4x1603 | 680 | 5% | 50V | 62.5mW |  |  | €0.10 | https://nl.mouser.com/ProductDetail/Bourns/CAY16-681J4LF?qs=fd0Ij%252BN8svzpg8SscutFRQ%3D%3D
ESD/TVS diode | PESD5Z5.0F | Nexperia | SOD523 | 5V |  |  |  |  |  | €0.10 | https://nl.mouser.com/ProductDetail/Nexperia/PESD5Z5.0F?qs=HNBw3F7vE2wb3Eh3cMl6Jg%3D%3D
LED | WP7113ND | Kingbright | 5mm | Orange | 10mA | 1.95V |  |  |  | €0.27 | https://nl.mouser.com/ProductDetail/Kingbright/WP7113ND?qs=CJFmpBjNieP5MCFQ3vDfmg%3D%3D
LED | WP7113GD | Kingbright | 5mm | Green | 10mA | 2V |  |  |  | €0.28 | https://nl.mouser.com/ProductDetail/Kingbright/WP7113GD?qs=pz0eHrWKk7njL1kTYKysuw%3D%3D
Microcontroller | ATTINY9-TS8R | Microchip Technology | SOT-23-6 | 10Mhz | 1kB | 32B |  |  |  | €0.38 | https://nl.mouser.com/ProductDetail/Microchip-Technology/ATTINY9-TS8R?qs=%2Fqzd9s%252BcLd6Ex7DNcGSsRA%3D%3D
Microcontroller | STM32H533ZET6 | STMicroelectronics | LQFP-144 | 250MHz | 512kB | 272kB |  |  |  | €6.67 | https://nl.mouser.com/ProductDetail/STMicroelectronics/STM32H533ZET6?qs=ZcfC38r4PouZSSZwvN%2F0rg%3D%3D
Buck converter | ADP2302ARDZ-3.3-R7 | Analog Devices | SOIC-8 | 3.3V | 2A | 20V |  |  |  | €3.95 | https://nl.mouser.com/ProductDetail/Analog-Devices/ADP2302ARDZ-3.3-R7?qs=WIvQP4zGaniwiePzHO4kIg%3D%3D
ESD/TVS diode | P4SMAJ12A | Diotec Semiconductor | SMA | 12V |  |  |  |  |  | €0.10 | https://nl.mouser.com/ProductDetail/Diotec-Semiconductor/P4SMAJ12A?qs=OlC7AqGiEDnaukKU4ZG5Cw%3D%3D
Inductor | SRN8040TA-6R8M | Bourns | 8x8x5.5mm | 6.8u | 5.1A |  |  |  |  | €0.50 | https://nl.mouser.com/ProductDetail/Bourns/SRN8040TA-6R8M?qs=Vt59ZOdFuWZKzofY7uJPVA%3D%3D
Connector | 67996-100HLF | Amphenol FCI | - | 2x1-pin | 2.54mm | 2A |  |  |  | €0.09 | https://nl.mouser.com/ProductDetail/Amphenol-FCI/67996-100HLF?qs=Nl1avnnkqqz0q6XiMQ3VCw%3D%3D
Connector | TST-110-01-F-D | Samtec | - | 2x10-pin | 2.54mm | 2A |  |  |  | €2.33 | https://nl.mouser.com/ProductDetail/Samtec/TST-110-01-F-D?qs=rU5fayqh%252BE0Ee6McwOe2fQ%3D%3D
Fuse | 1206L075_16WR | Littlefuse | 1206 | 1.5A | 16V |  |  |  |  | €0.89 | https://nl.mouser.com/ProductDetail/Littelfuse/1206L075-16WR?qs=TVaBpCI%2FeOg5hXJBAaxqag%3D%3D
Button | TS20-42-25-WT-160-SMT-TR | Same Sky | - | NO |  |  |  |  |  | €0.27 | https://nl.mouser.com/ProductDetail/Same-Sky/TS20-42-25-WT-160-SMT-TR?qs=tlsG%2FOw5FFiXbig16X7ymQ%3D%3D
Schottky diode | SSB43L-E3_5BT | Vishay / Dale | SMB | 30V | 4A |  |  |  |  | €0.55 | https://nl.mouser.com/ProductDetail/Vishay-General-Semiconductor/SSB43L-E3-5BT?qs=x2jpVgRnAtNiPuGHUYcyzg%3D%3D
ESD/TVS diode | PESD2USB5UXT-QR | Nexperia | SOT-23-3 | 3.3V |  |  |  |  |  | €0.26 | https://nl.mouser.com/ProductDetail/Nexperia/PESD2USB5UXT-QR?qs=3Rah4i%252BhyCET5tUF%2FP4H8w%3D%3D
SRAM | AS6C6416-55TIN | Alliance Memory | TSOP-48 | parallel | 64Mb | 4Mx16 | 3.3V |  |  | €24.71 | https://nl.mouser.com/ProductDetail/Alliance-Memory/AS6C6416-55TIN?qs=GmNq1OH0n5SzDB5s%252B7Ym0A%3D%3D
Crystal | ECS-160-12-30BQ-ADS-TR | ECS | 5x3.2mm | 16Mhz | 12pF |  |  |  |  | €0.48 | https://nl.mouser.com/ProductDetail/ECS/ECS-160-12-30BQ-ADS-TR?qs=wd5RIQLrsJjwIYL6caSorA%3D%3D
LED | 150060GS83000 | Wurth Electronik | 0603 | Amber | 20mA | 3.3V |  |  |  | €0.25 | https://nl.mouser.com/ProductDetail/Wurth-Elektronik/150060GS83000?qs=3GbUB62Nf7fgC6%2FTmce6tQ%3D%3D
Connector | PRT-10811 | SparkFun | - | 2.1mm | - | 4A |  |  |  | €1.08 | https://nl.mouser.com/ProductDetail/SparkFun/PRT-10811?qs=WyAARYrbSna7U1x2Qa%2FYmw%3D%3D
Connector | MSD-1-A | Same Sky | - | uSD | - | - |  |  |  | €0.31 | https://nl.mouser.com/ProductDetail/Same-Sky/MSD-1-A
Capacitor | C0402C104M9RACTU | KEMET | 0402 | 100n | 20% | 6.3V |  |  |  | €0.09 | https://nl.mouser.com/ProductDetail/KEMET/C0402C104M9RACTU?qs=JZ1tlzCDhS6kDDvZO7DmSw%3D%3D
Capacitor | C0402C160M4HACAUTO | KEMET | 0402 | 16p | 20% | 16V |  |  |  | €0.10 | https://nl.mouser.com/ProductDetail/KEMET/C0402C160M4HACAUTO?qs=j%252B1pi9TdxUazVHMguOuuEw%3D%3D
Capacitor | CL31A226MQHNNNE | Samsung Electro-Mechanics | 1206 | 22u | 20% | 6.3V |  |  |  | €0.21 | https://nl.mouser.com/ProductDetail/Samsung-Electro-Mechanics/CL31A226MQHNNNE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
Capacitor | JMK107BJ475MA-T | TAIYO YUDEN | 0603 | 4.7u | 20% | 6.3V |  |  |  | €0.09 | https://nl.mouser.com/ProductDetail/TAIYO-YUDEN/JMK107BJ475MA-T?qs=I6KAKw0tg2w70pBrhX9IlQ%3D%3D
Resistor | CR0402-FX-1022GLF | Bourns | 0402 | 10.2k | 1% | 50V | 62.5mW |  |  | €0.09 | https://nl.mouser.com/ProductDetail/Bourns/CR0402-FX-1022GLF?qs=URDPQ%2Fj0cz0dXXje%252BNROsQ%3D%3D
Resistor | RT0402FRE0731K6L | YAGEO | 0402 | 31.6k | 1% | 50V | 62.5mW |  |  | €0.09 | https://nl.mouser.com/ProductDetail/YAGEO/RT0402FRE0731K6L?qs=gY0y7AQI9SOK9v5UlXnp5Q%3D%3D
