JustinVerkade/KiCadLibraryProcessor/SamacSysLibs/JVER_Models/IS61WV20488FBLL-10BLI.stp

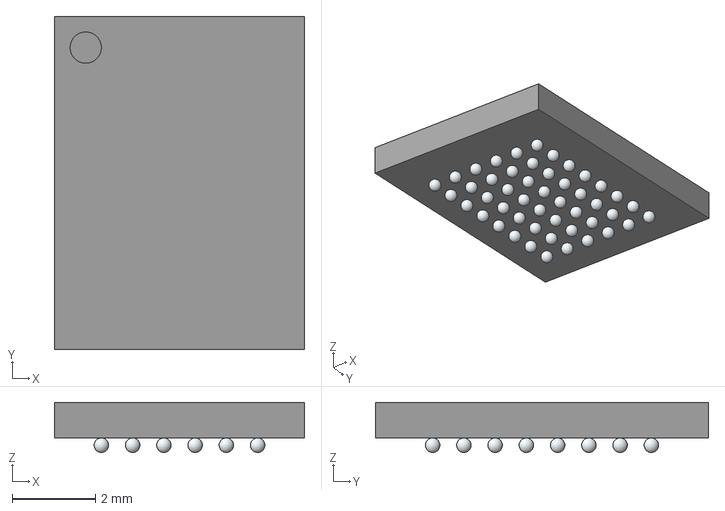
[picture p1: CAD file, 2025-08-14]
SamacSysLibs/JVER_Models/IS61WV20488FBLL-10BLI.stp
6.00 x 8.00 x 1.20 mm
