JustinVerkade/KiCadLibraryProcessor/SamacSysLibs/JVER_Models/MSD-1-A.stp

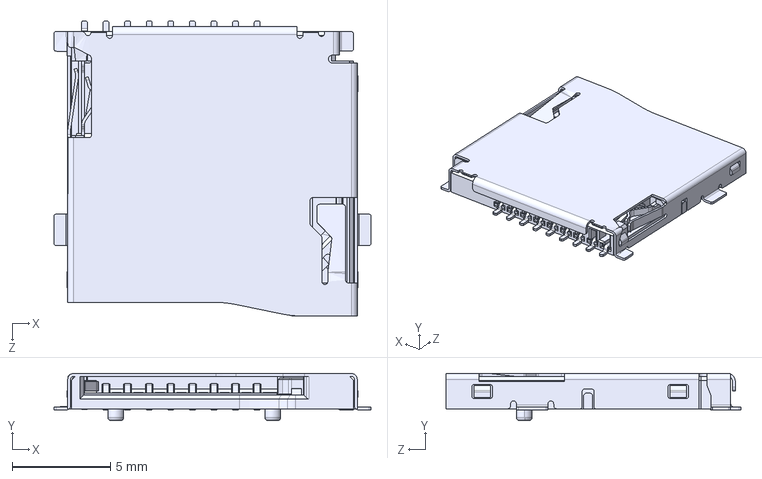
[picture p2: CAD file, 2025-08-14]
SamacSysLibs/JVER_Models/MSD-1-A.stp
16.1 x 2.40 x 15.0 mm
