JustinVerkade/KiCadLibraryProcessor/SamacSysLibs/JVER_Models/STM32H7A3LIH6Q.stp

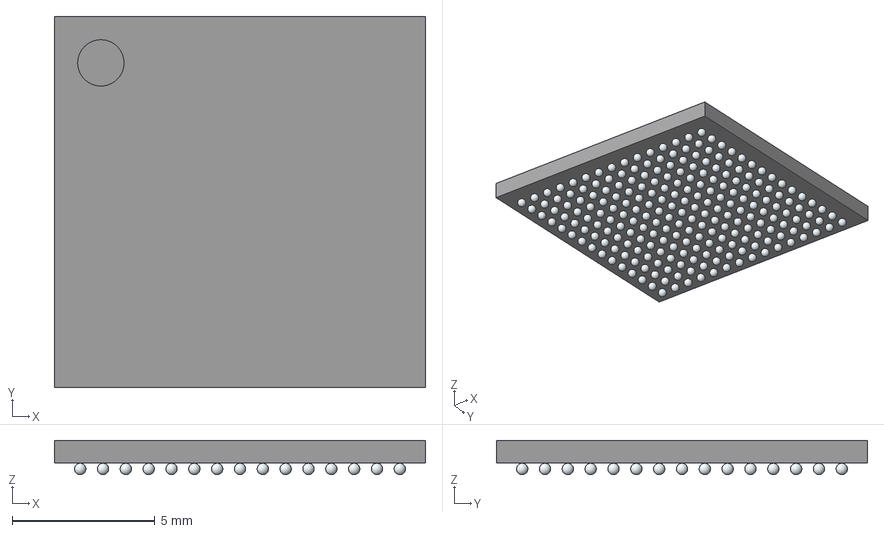
[picture p3: CAD file, 2025-08-14]
SamacSysLibs/JVER_Models/STM32H7A3LIH6Q.stp
13.0 x 13.0 x 1.20 mm
