JustinVerkade/KiCadLibraryProcessor/SamacSysLibs/JVER_Models/PESD2USB5UXT-QR.stp

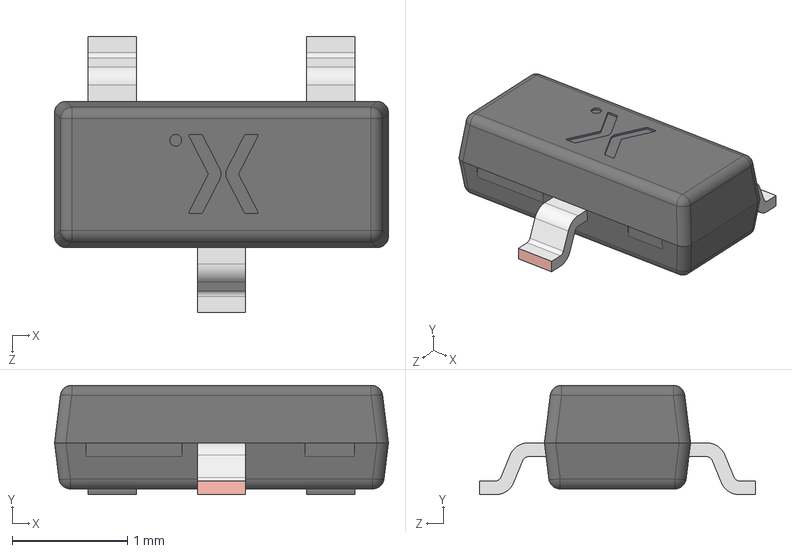
[picture p4: CAD file, 2025-08-14]
SamacSysLibs/JVER_Models/PESD2USB5UXT-QR.stp
2.90 x 0.95 x 2.40 mm
SOT23 lower body
SOT23 Lead x 3
SOT23 Upper body
