JustinVerkade/KiCadLibraryProcessor/SamacSysLibs/JVER_Models/SRN8040TA-6R8M.stp

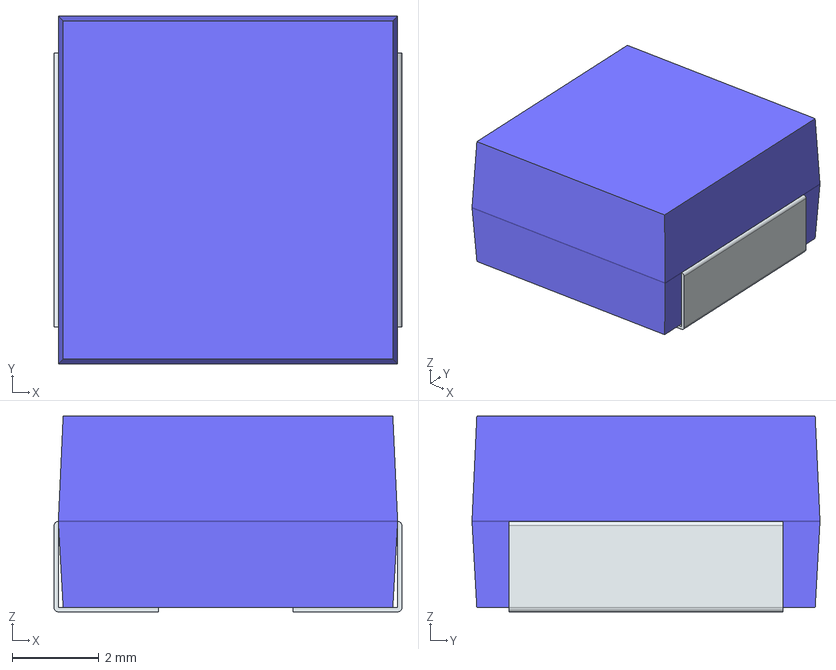
[picture p5: CAD file, 2025-08-14]
SamacSysLibs/JVER_Models/SRN8040TA-6R8M.stp
8.00 x 8.00 x 4.50 mm
FilletPin1
FilletPin2
