JustinVerkade/KiCadLibraryProcessor/SamacSysLibs/JVER_Models/TS20-42-25-WT-160-SMT-TR.stp

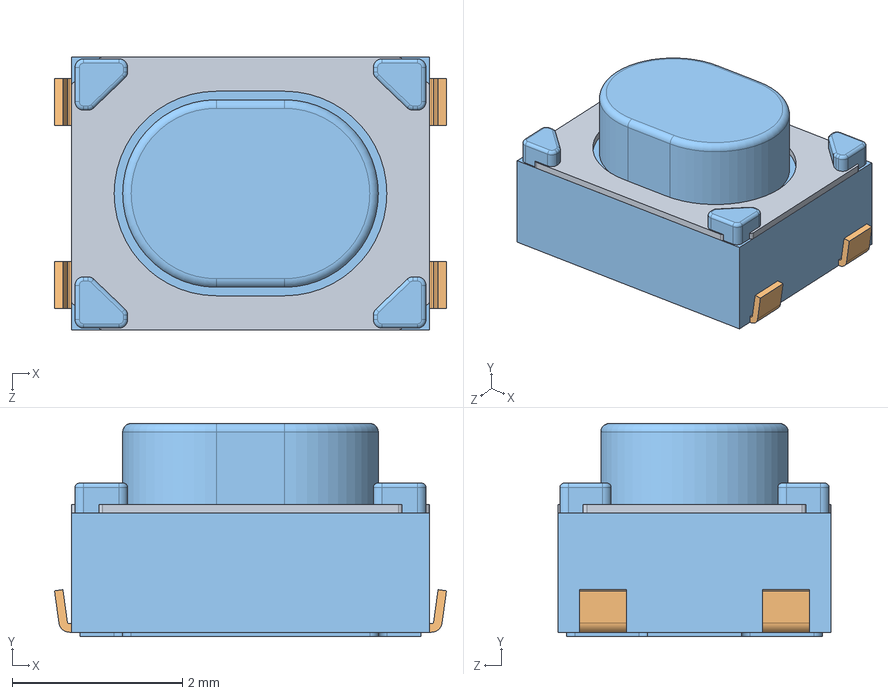
[picture p6: CAD file, 2025-08-14]
SamacSysLibs/JVER_Models/TS20-42-25-WT-160-SMT-TR.stp
4.60 x 2.50 x 3.20 mm
