JustinVerkade/KiCadLibraryProcessor/SamacSysLibs/JVER_Models/P4SMAJ12A.stp

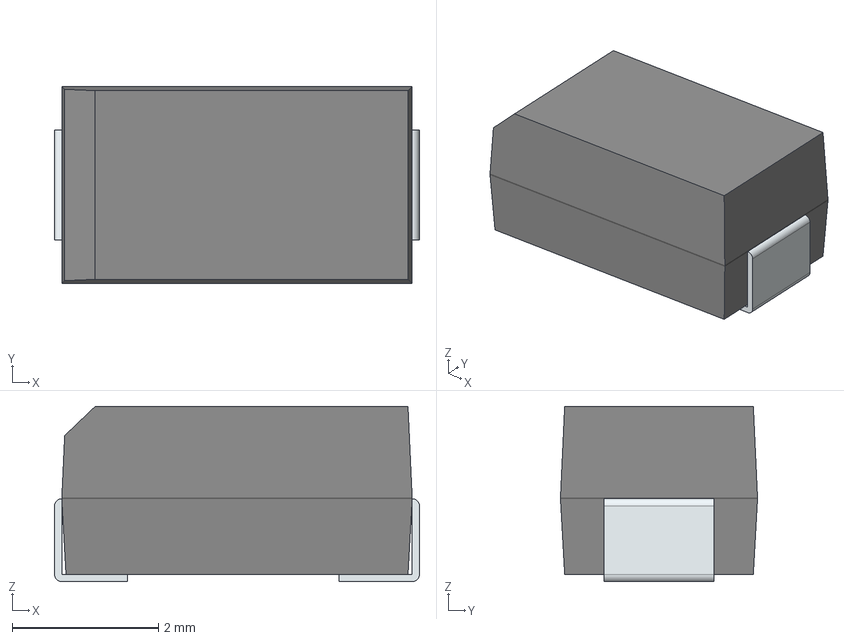
[picture p7: CAD file, 2025-08-14]
SamacSysLibs/JVER_Models/P4SMAJ12A.stp
5.00 x 2.70 x 2.40 mm
FilletPin1
FilletPin2
