JustinVerkade/KiCadLibraryProcessor/SamacSysLibs/JVER_Models/ECS-160-12-30BQ-ADS-TR.stp

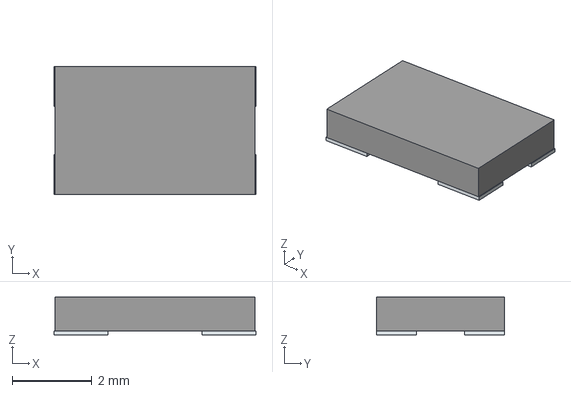
[picture p8: CAD file, 2025-08-14]
SamacSysLibs/JVER_Models/ECS-160-12-30BQ-ADS-TR.stp
5.05 x 3.20 x 0.95 mm
Pins
