JustinVerkade/KiCadLibraryProcessor/SamacSysLibs/JVER_Models/PRT-10811.stp

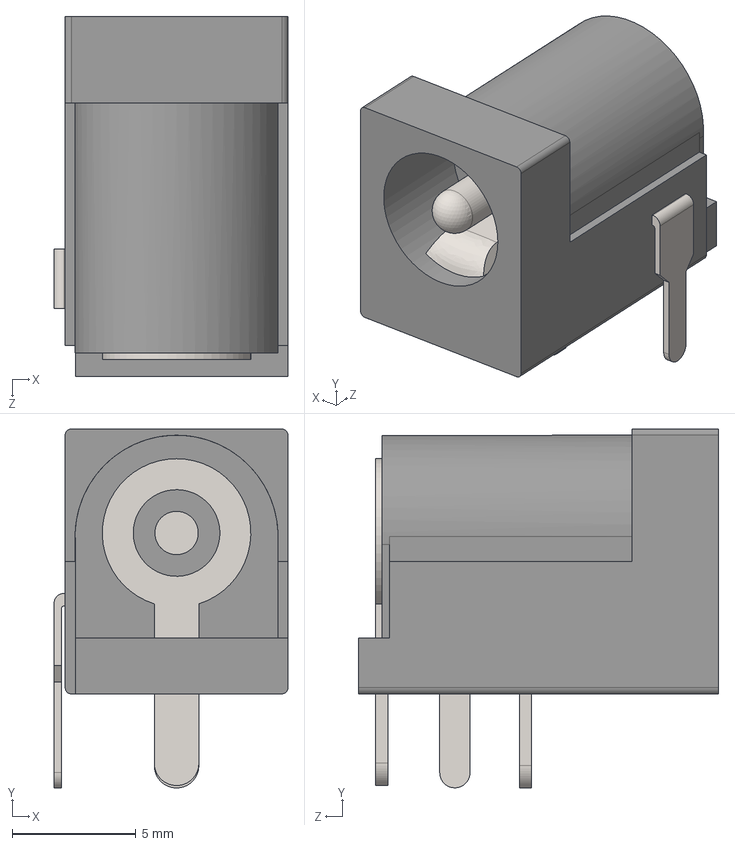
[picture p9: CAD file, 2025-08-14]
SamacSysLibs/JVER_Models/PRT-10811.stp
9.45 x 14.5 x 14.6 mm
