JustinVerkade/KiCadLibraryProcessor/SamacSysLibs/JVER_Models/TST-110-01-F-D.stp

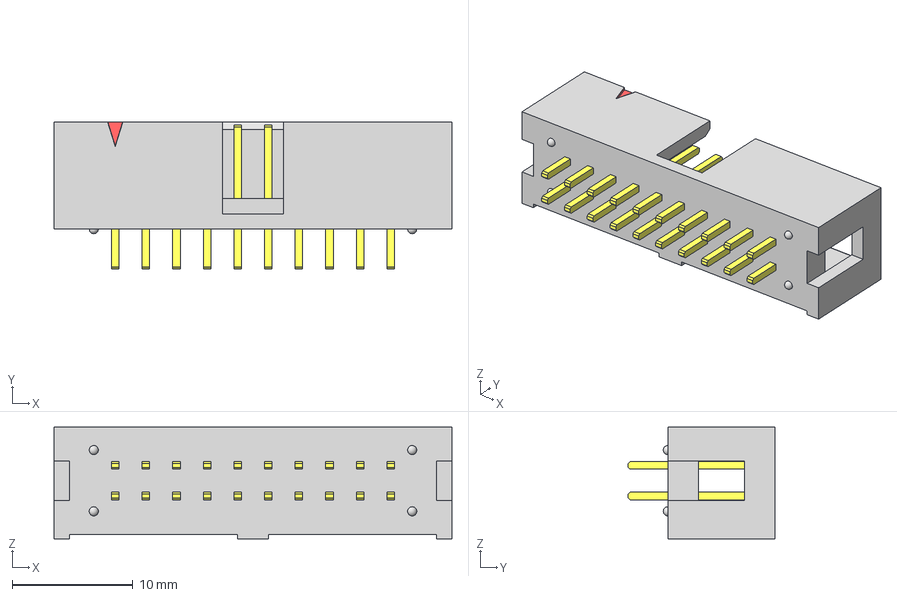
[picture p10: CAD file, 2025-08-14]
SamacSysLibs/JVER_Models/TST-110-01-F-D.stp
33.0 x 12.2 x 9.27 mm
TST-110-01-D_header
TST-First_Position_Indicator
T-1S6-10-01-D
