JustinVerkade/KiCadLibraryProcessor/SamacSysLibs/JVER_Models/SSB43L-E3_5BT.stp

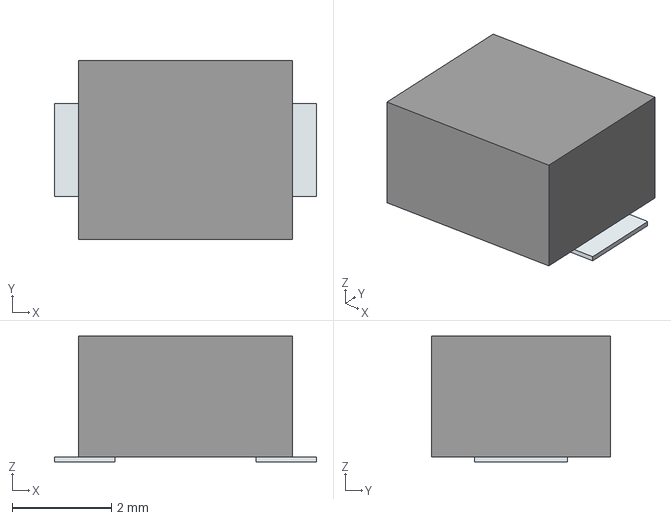
[picture p11: CAD file, 2025-08-14]
SamacSysLibs/JVER_Models/SSB43L-E3_5BT.stp
5.29 x 3.62 x 2.54 mm
Pins
