JustinVerkade/KiCadLibraryProcessor/SamacSysLibs/JVER_Models/ADP2302ARDZ-3.3-R7.stp

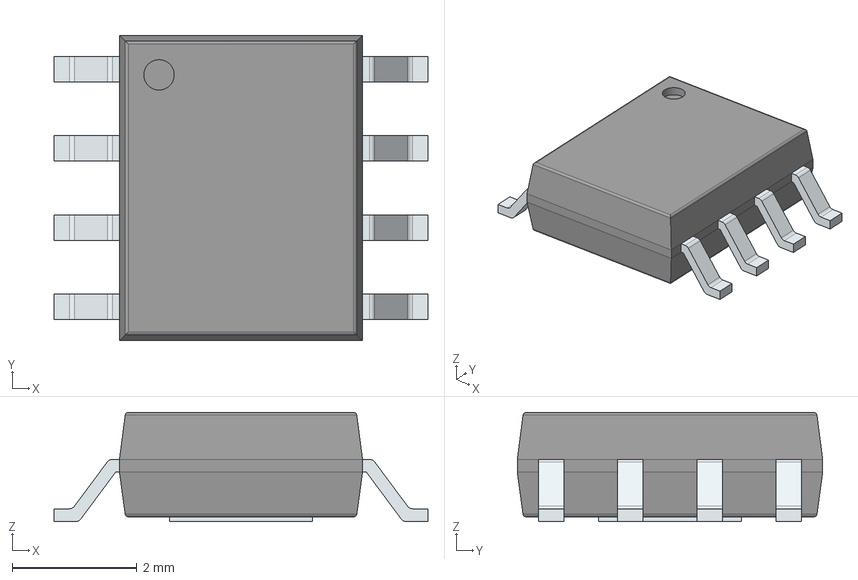
[picture p12: CAD file, 2025-08-14]
SamacSysLibs/JVER_Models/ADP2302ARDZ-3.3-R7.stp
6.00 x 4.90 x 1.75 mm
PinsArrayLR
ThermalPad
