JustinVerkade/KiCadLibraryProcessor/SamacSysLibs/JVER_Models/AS6C6416-55TIN.stp

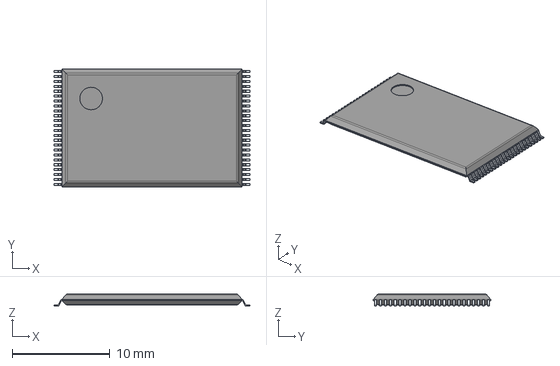
[picture p13: CAD file, 2025-08-14]
SamacSysLibs/JVER_Models/AS6C6416-55TIN.stp
20.0 x 12.0 x 1.20 mm
PinsArrayLR
