JustinVerkade/KiCadLibraryProcessor/SamacSysLibs/JVER_Models/STM32C071GBU6.stp

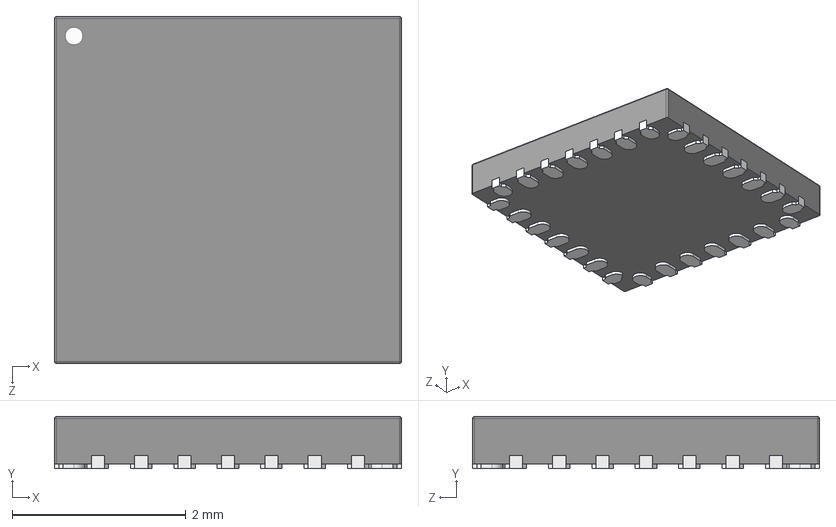
[picture p14: CAD file, 2025-03-11]
SamacSysLibs/JVER_Models/STM32C071GBU6.stp
4.00 x 0.601 x 4.00 mm
