JustinVerkade/KiCadLibraryProcessor/SamacSysLibs/JVER_Models/SM15T15A.stp

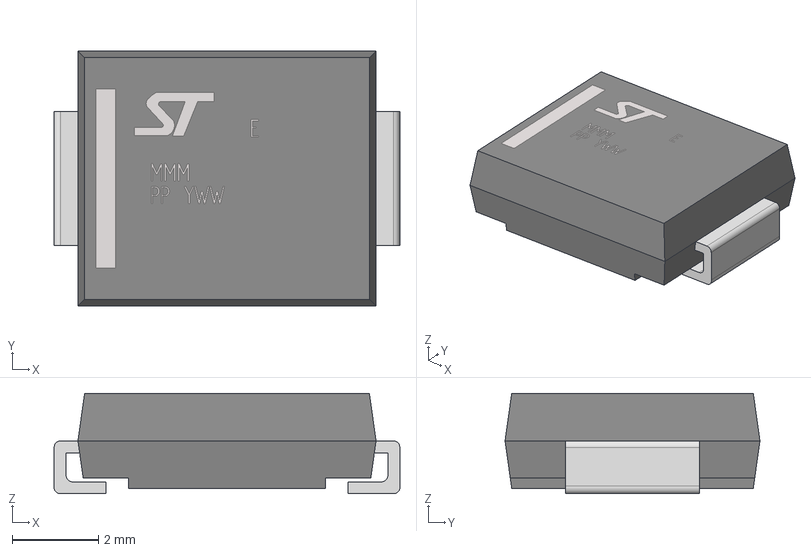
[picture p15: CAD file, 2025-02-22]
SamacSysLibs/JVER_Models/SM15T15A.stp
8.01 x 5.90 x 2.33 mm
