JustinVerkade/KiCadLibraryProcessor/SamacSysLibs/JVER_Models/LM339LVPWR.stp

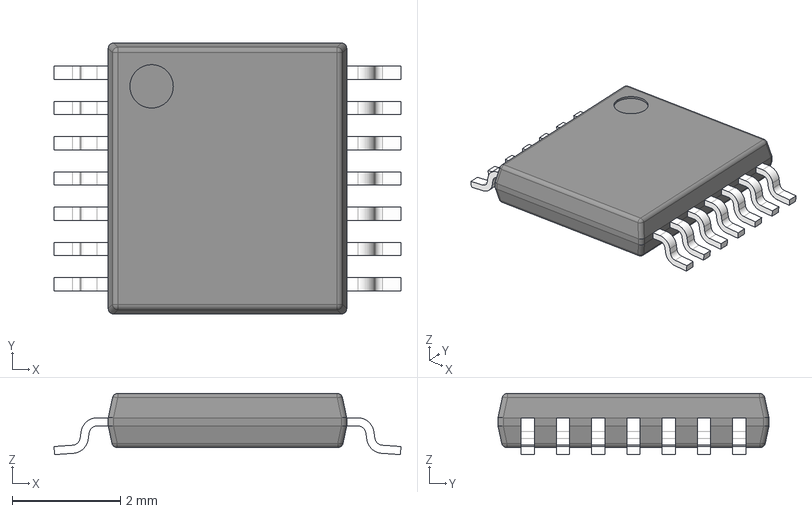
[picture p16: CAD file, 2025-02-21]
SamacSysLibs/JVER_Models/LM339LVPWR.stp
6.40 x 5.00 x 1.13 mm
BODY-TSSOP
LEAD-TSSOP x 14
PIN1
