JustinVerkade/KiCadLibraryProcessor/SamacSysLibs/JVER_Models/ESD5Z5.0T5G.stp

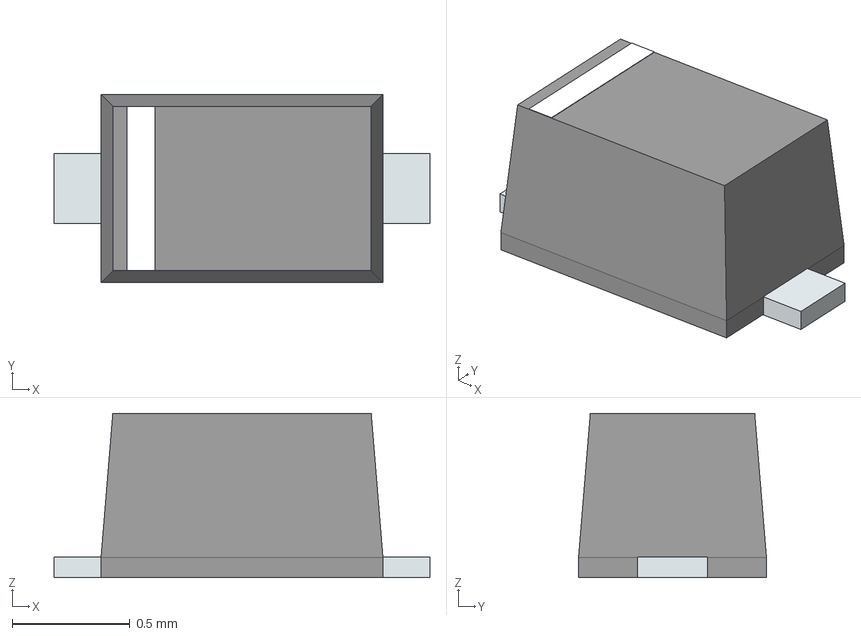
[picture p17: CAD file, 2025-02-21]
SamacSysLibs/JVER_Models/ESD5Z5.0T5G.stp
1.60 x 0.8 x 0.7 mm
PinKIdent
PinK
PinA
