JustinVerkade/KiCadLibraryProcessor/SamacSysLibs/JVER_Models/MLZ1608A2R2MT.stp

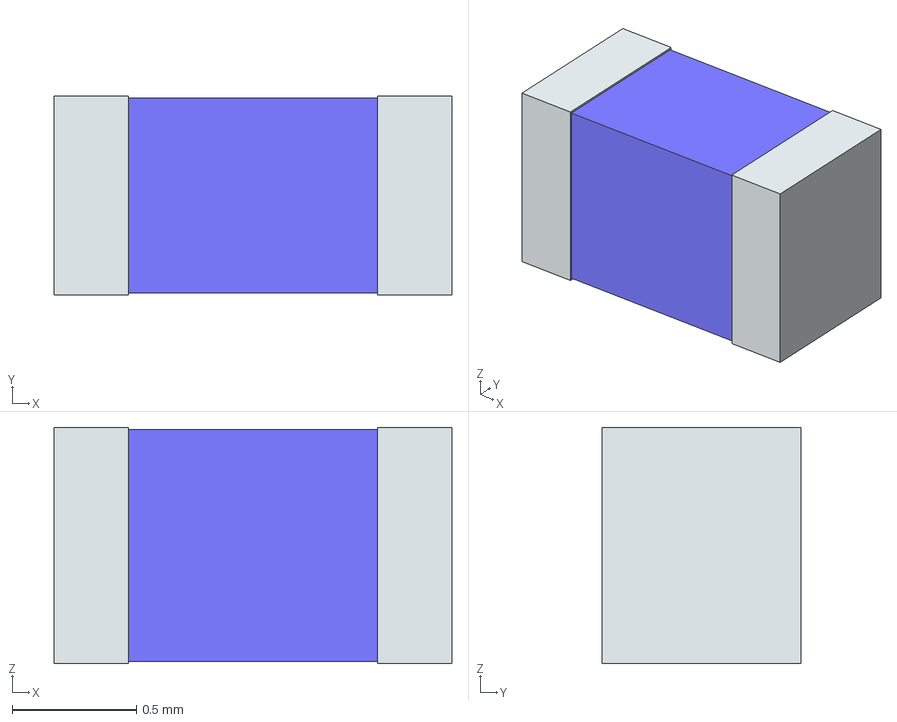
[picture p18: CAD file, 2025-02-21]
SamacSysLibs/JVER_Models/MLZ1608A2R2MT.stp
1.60 x 0.8 x 0.95 mm
term1
term2
