JustinVerkade/KiCadLibraryProcessor/SamacSysLibs/JVER_Models/ESD9P5.0ST5G.stp

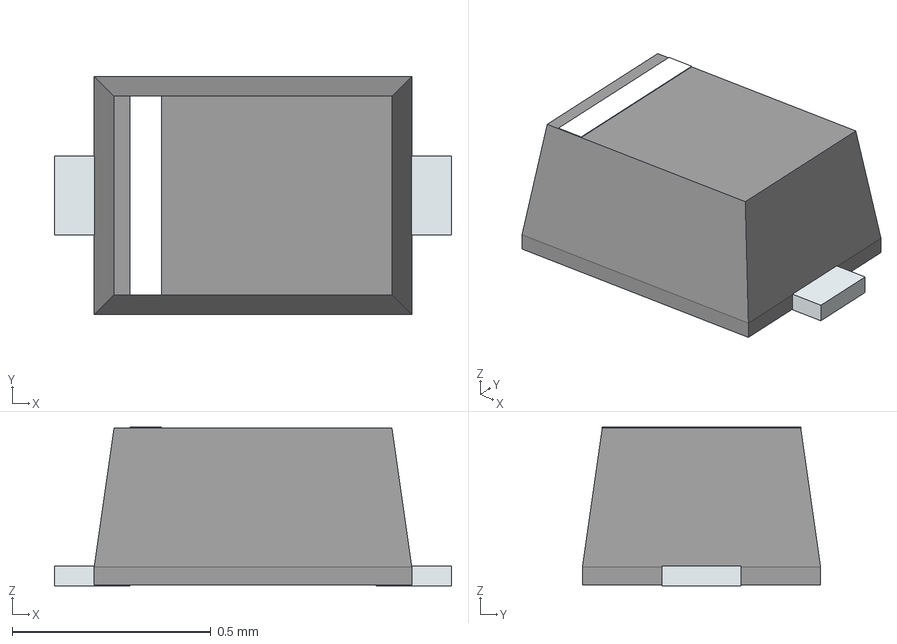
[picture p19: CAD file, 2025-02-21]
SamacSysLibs/JVER_Models/ESD9P5.0ST5G.stp
1.00 x 0.6 x 0.4 mm
PinKIdent
PinK
PinA
