JustinVerkade/KiCadLibraryProcessor/SamacSysLibs/JVER_Models/IHLP3232DZER4R7M11.stp

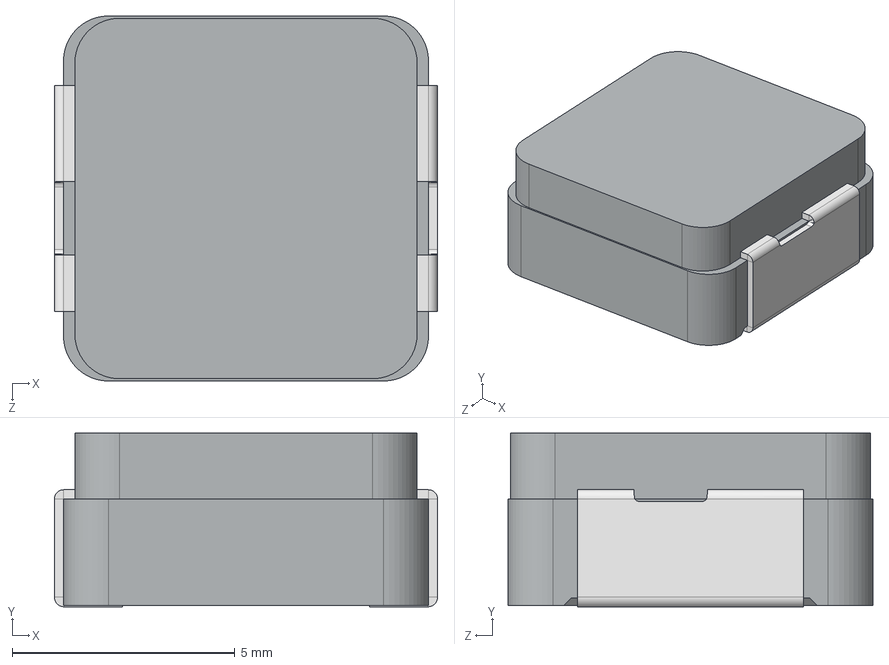
[picture p20: CAD file, 2025-02-21]
SamacSysLibs/JVER_Models/IHLP3232DZER4R7M11.stp
8.60 x 3.90 x 8.19 mm
