JustinVerkade/KiCadLibraryProcessor/SamacSysLibs/JVER_Models/TSM080N03EPQ56_RLG.stp

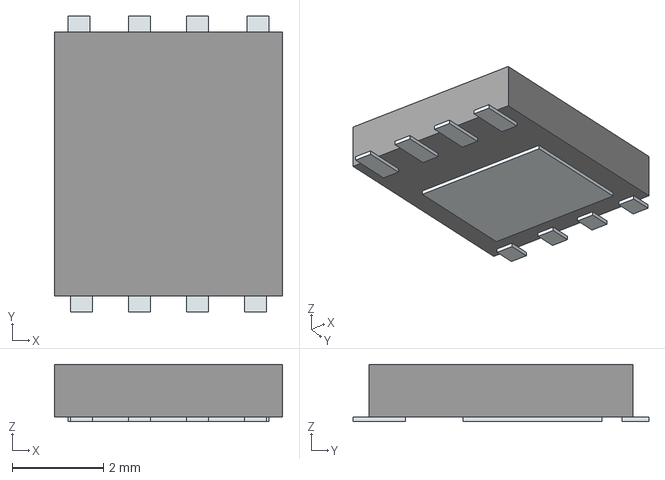
[picture p21: CAD file, 2025-02-21]
SamacSysLibs/JVER_Models/TSM080N03EPQ56_RLG.stp
5.00 x 6.49 x 1.25 mm
Pins
