JustinVerkade/KiCadLibraryProcessor/SamacSysLibs/JVER_Models/RF4E100AJTCR.stp

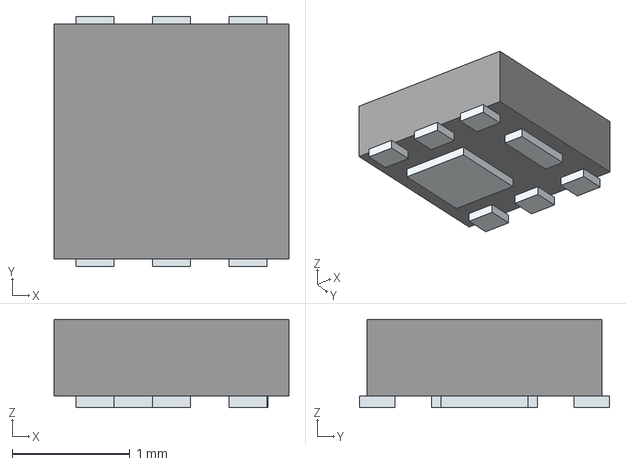
[picture p22: CAD file, 2025-02-21]
SamacSysLibs/JVER_Models/RF4E100AJTCR.stp
2.00 x 2.12 x 0.75 mm
Pins
