JustinVerkade/KiCadLibraryProcessor/SamacSysLibs/JVER_Models/RUM001L02T2CL.stp

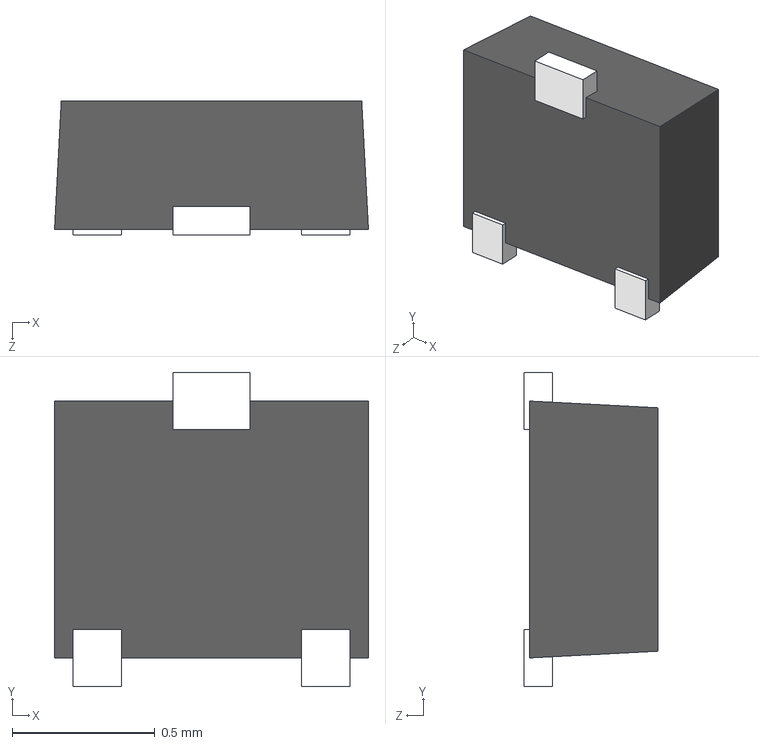
[picture p23: CAD file, 2025-02-21]
SamacSysLibs/JVER_Models/RUM001L02T2CL.stp
1.10 x 1.10 x 0.47 mm
