JustinVerkade/KiCadLibraryProcessor/SamacSysLibs/JVER_Models/CSNL1206FT20L0.stp

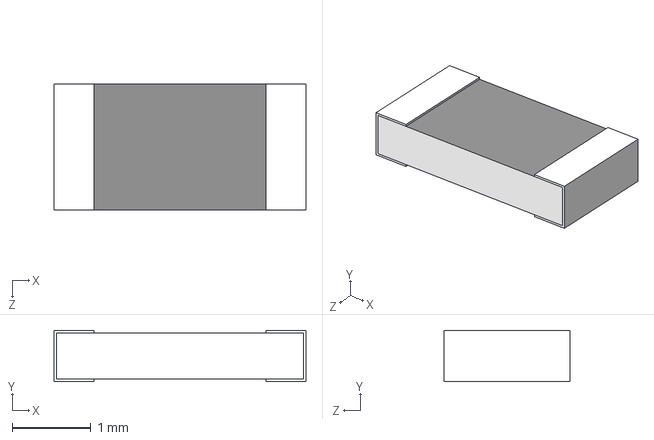
[picture p24: CAD file, 2025-02-21]
SamacSysLibs/JVER_Models/CSNL1206FT20L0.stp
3.20 x 0.65 x 1.60 mm
