JustinVerkade/KiCadLibraryProcessor/SamacSysLibs/JVER_Models/LM321LVIDCKR.stp

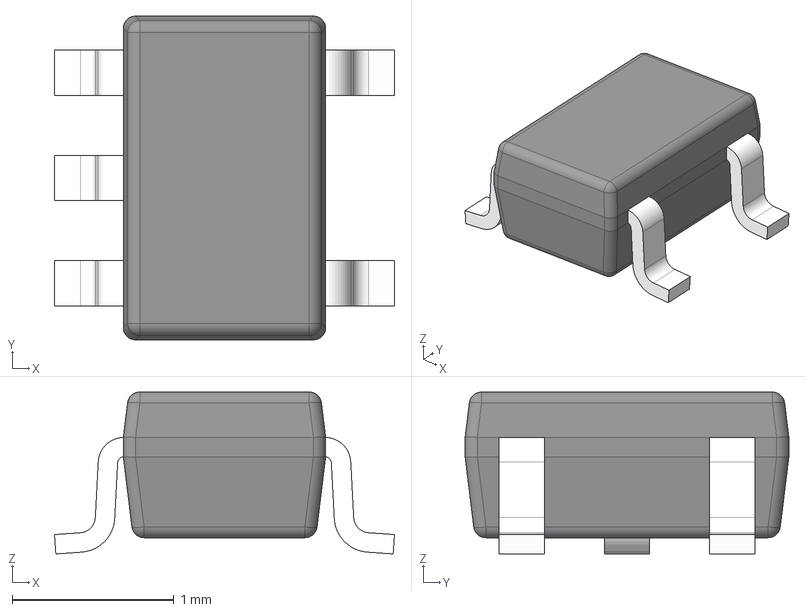
[picture p25: CAD file, 2025-02-21]
SamacSysLibs/JVER_Models/LM321LVIDCKR.stp
2.10 x 2.00 x 1.00 mm
BODY-SOT
LEAD-SOT x 5
PIN1-ID
