JustinVerkade/KiCadLibraryProcessor/SamacSysLibs/JVER_Models/39-30-6087.stp

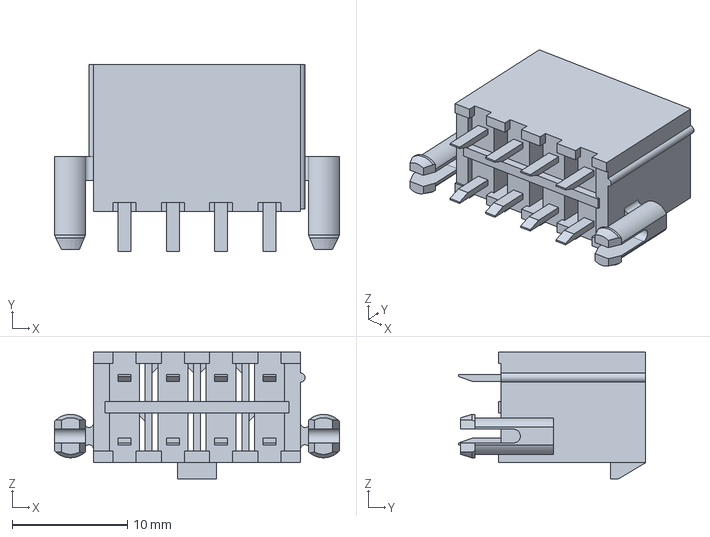
[picture p26: CAD file, 2025-02-21]
SamacSysLibs/JVER_Models/39-30-6087.stp
24.8 x 16.3 x 11.0 mm
