JustinVerkade/KiCadLibraryProcessor/SamacSysLibs/JVER_Models/TMC6200-TA.stp

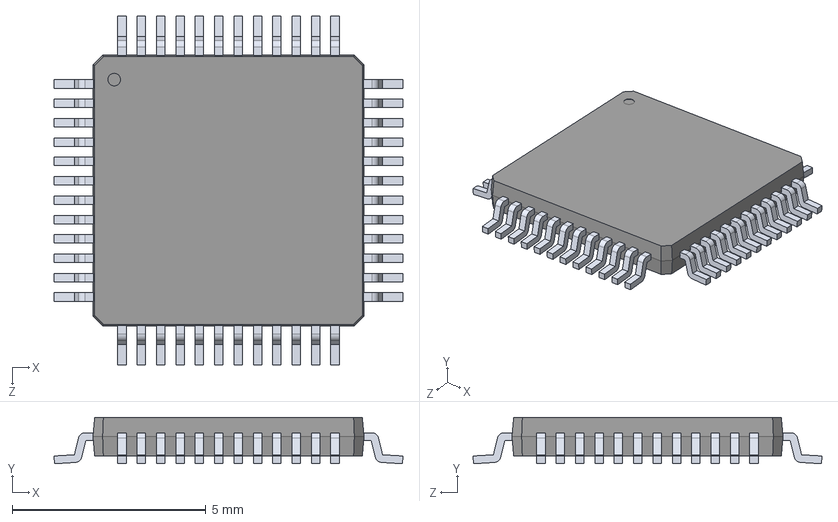
[picture p27: CAD file, 2025-02-21]
SamacSysLibs/JVER_Models/TMC6200-TA.stp
9.01 x 1.20 x 9.01 mm
