JustinVerkade/KiCadLibraryProcessor/SamacSysLibs/JVER_Models/STM32G0B1CBT3.stp

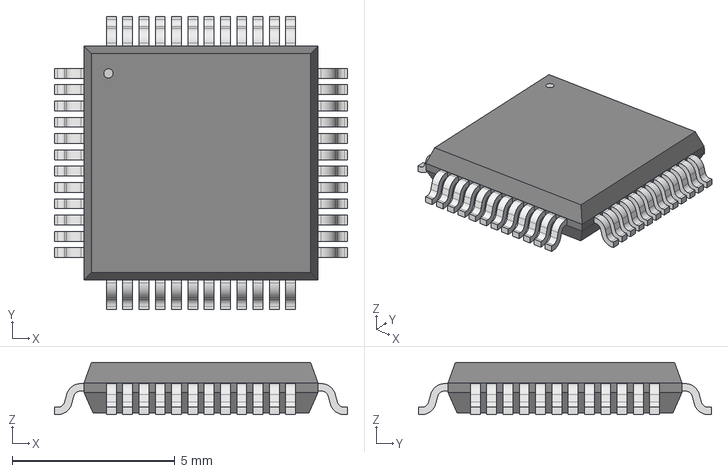
[picture p28: CAD file, 2025-02-21]
SamacSysLibs/JVER_Models/STM32G0B1CBT3.stp
8.99 x 8.99 x 1.60 mm
