JustinVerkade/KiCadLibraryProcessor/SamacSysLibs/JVER_Models/EEE-FT1H331AP.stp

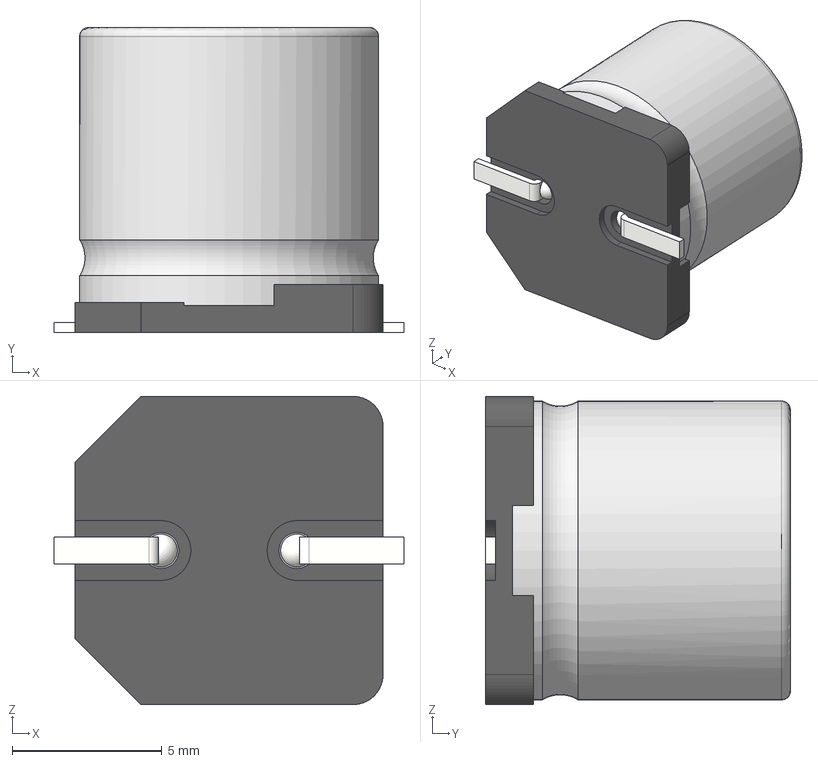
[picture p29: CAD file, 2025-02-21]
SamacSysLibs/JVER_Models/EEE-FT1H331AP.stp
11.7 x 10.2 x 10.3 mm
標準品ケースΦ10x9.3L SIDE CODE G
標準品座版Φ10 SIZE CODE G
標準品リード線Φ10 SIZE CODE G改 x 2
