JustinVerkade/KiCadLibraryProcessor/SamacSysLibs/JVER_Models/MLZ2012N4R7LT000.stp

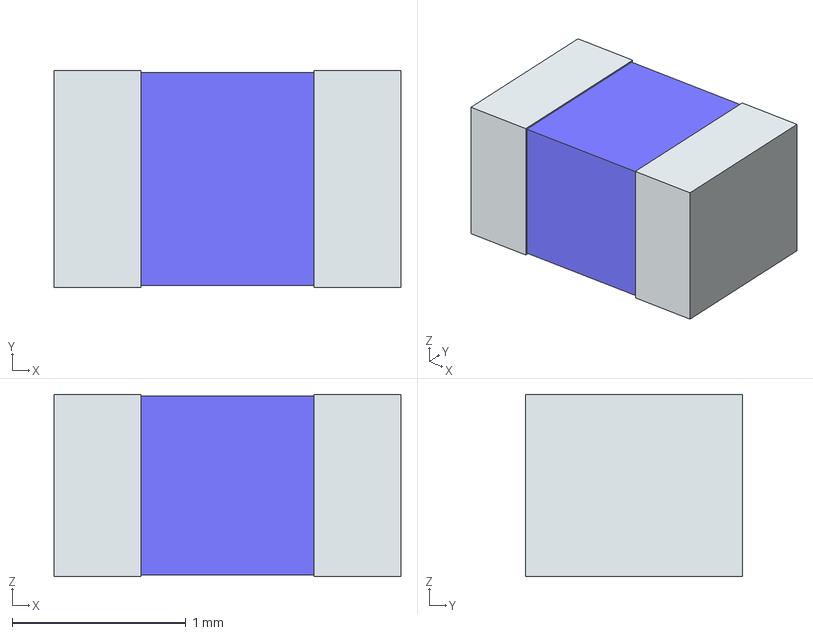
[picture p30: CAD file, 2025-02-16]
SamacSysLibs/JVER_Models/MLZ2012N4R7LT000.stp
2.00 x 1.25 x 1.05 mm
term1
term2
