JustinVerkade/KiCadLibraryProcessor/SamacSysLibs/JVER_Models/PTVS13VS1UR-QX.stp

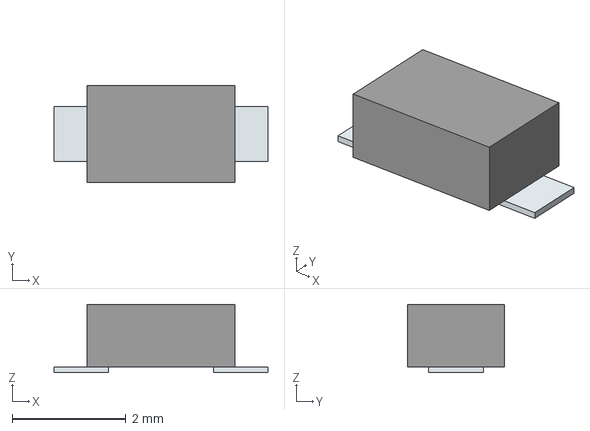
[picture p31: CAD file, 2025-02-16]
SamacSysLibs/JVER_Models/PTVS13VS1UR-QX.stp
3.76 x 1.70 x 1.20 mm
Pins
