JustinVerkade/KiCadLibraryProcessor/SamacSysLibs/JVER_Models/ECS-80-8-33B2Q-CVY-TR3.stp

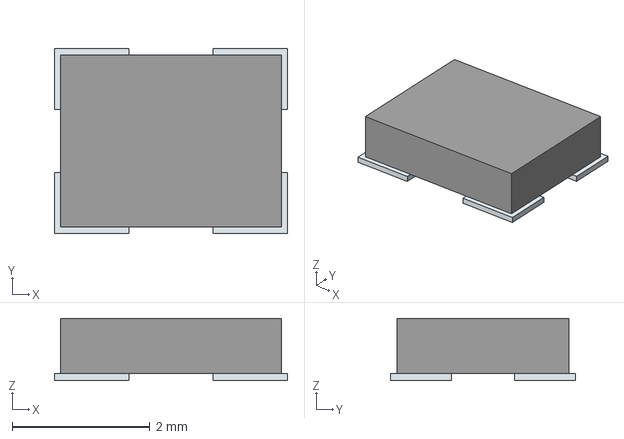
[picture p32: CAD file, 2025-02-16]
SamacSysLibs/JVER_Models/ECS-80-8-33B2Q-CVY-TR3.stp
3.38 x 2.68 x 0.9 mm
Pins
