JustinVerkade/KiCadLibraryProcessor/SamacSysLibs/JVER_Models/TLV1117LV33DCYR.stp

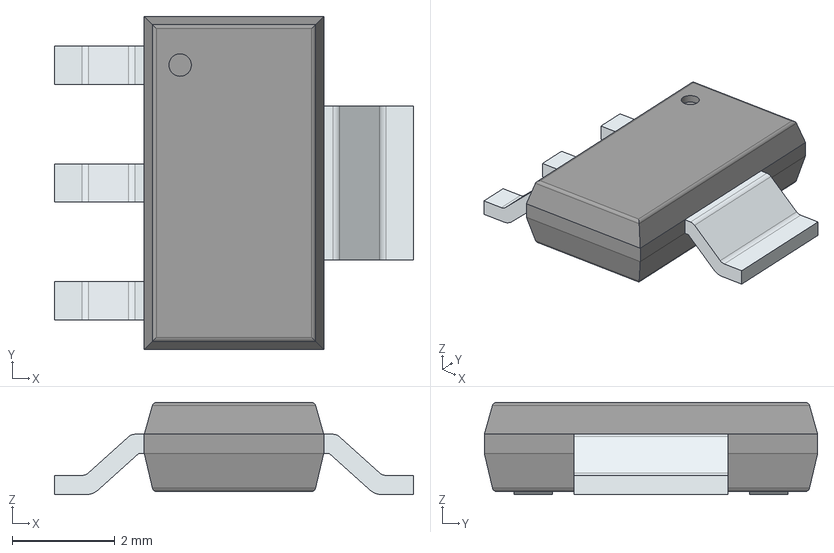
[picture p33: CAD file, 2025-02-16]
SamacSysLibs/JVER_Models/TLV1117LV33DCYR.stp
7.00 x 6.50 x 1.80 mm
PinsArrayL
FilletPinR
