JustinVerkade/KiCadLibraryProcessor/SamacSysLibs/JVER_Models/IFSC1616AHER4R7M01.stp

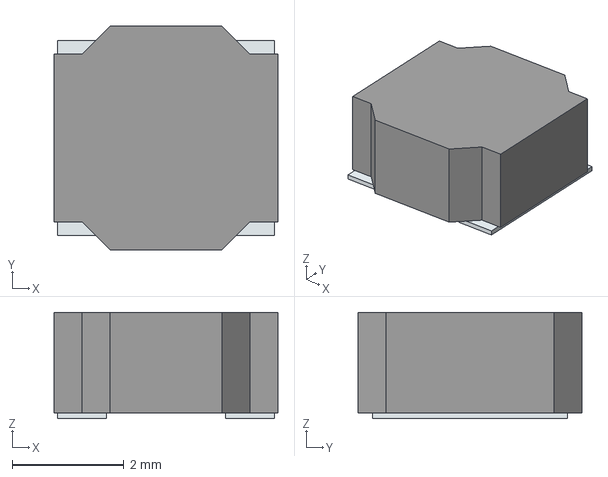
[picture p34: CAD file, 2025-02-16]
SamacSysLibs/JVER_Models/IFSC1616AHER4R7M01.stp
4.00 x 4.00 x 1.90 mm
Pins
