JustinVerkade/KiCadLibraryProcessor/SamacSysLibs/JVER_Models/LSM6DS3TR-C.stp

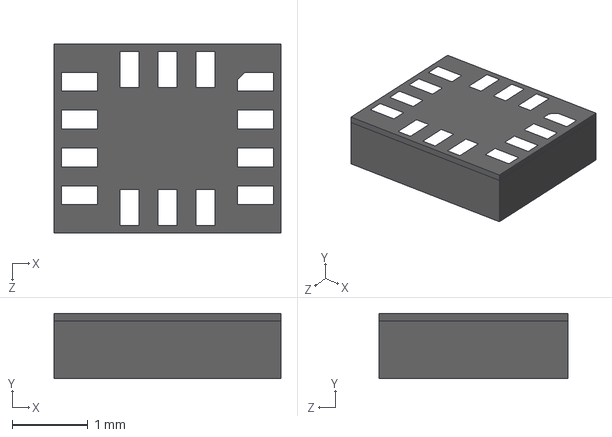
[picture p35: CAD file, 2025-02-16]
SamacSysLibs/JVER_Models/LSM6DS3TR-C.stp
3.00 x 0.86 x 2.50 mm
