JustinVerkade/KiCadLibraryProcessor/SamacSysLibs/JVER_Models/BZT52C5V6-TP.stp

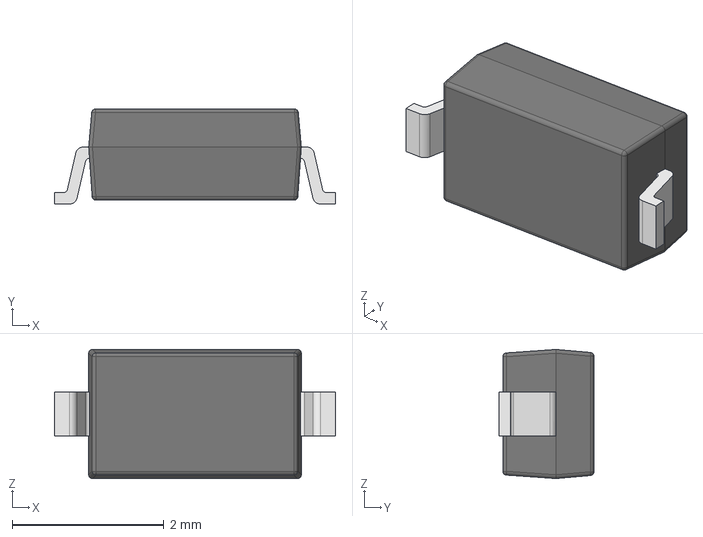
[picture p36: CAD file, 2025-02-16]
SamacSysLibs/JVER_Models/BZT52C5V6-TP.stp
3.70 x 1.25 x 1.70 mm
��1
��2
