JustinVerkade/KiCadLibraryProcessor/SamacSysLibs/JVER_Models/PKLCS1212E2400-R1.stp

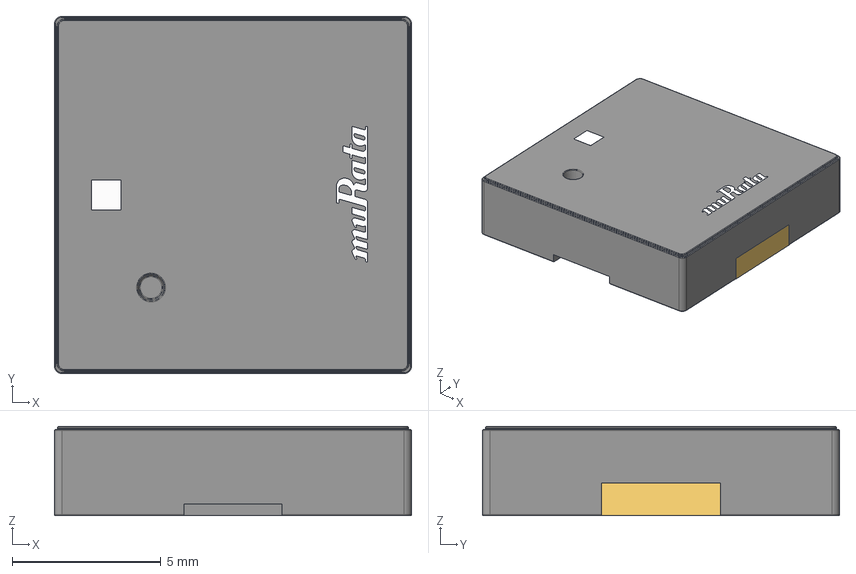
[picture p37: CAD file, 2025-02-16]
SamacSysLibs/JVER_Models/PKLCS1212E2400-R1.stp
12.0 x 12.0 x 3.00 mm
terminals
marking
