JustinVerkade/KiCadLibraryProcessor/SamacSysLibs/JVER_Models/BWCU00321619102M02.stp

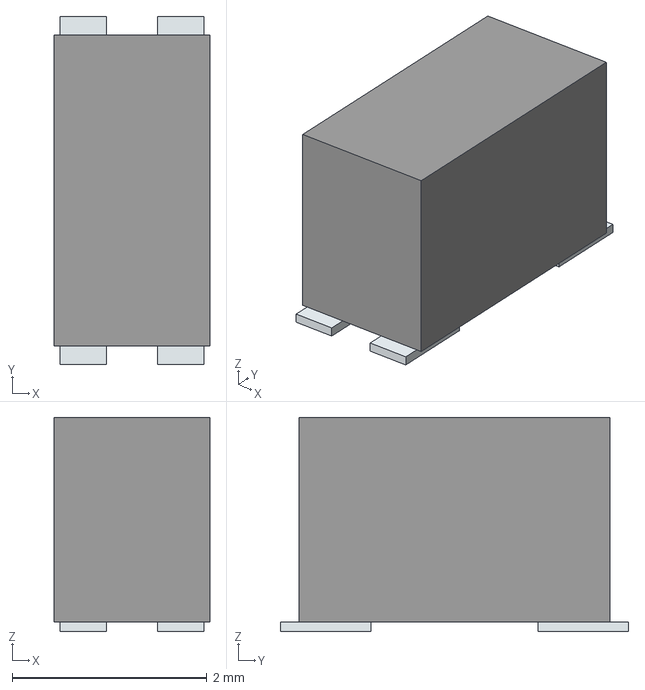
[picture p38: CAD file, 2025-02-11]
SamacSysLibs/JVER_Models/BWCU00321619102M02.stp
1.60 x 3.58 x 2.20 mm
Pins
