JustinVerkade/KiCadLibraryProcessor/SamacSysLibs/JVER_Models/DMN63D8L-7.stp

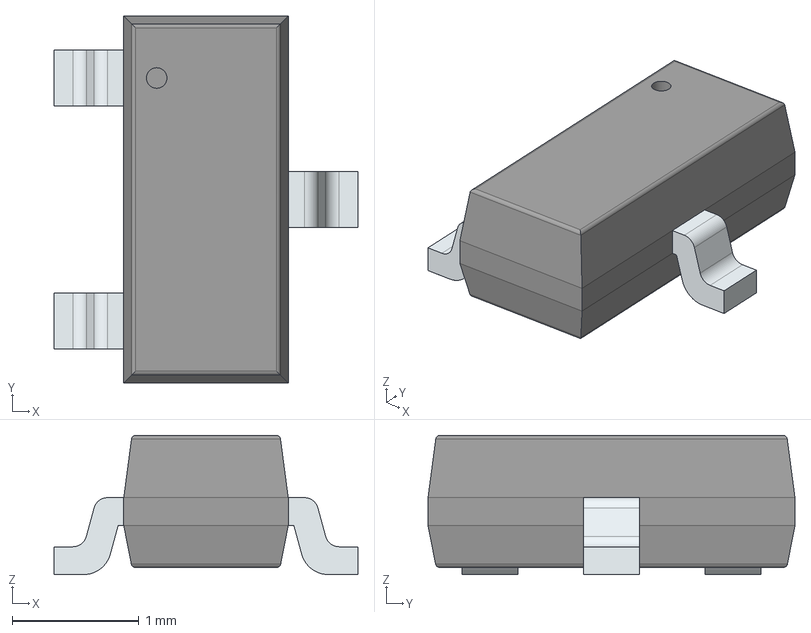
[picture p39: CAD file, 2025-02-11]
SamacSysLibs/JVER_Models/DMN63D8L-7.stp
2.40 x 2.90 x 1.10 mm
PinsArrayL
FilletPinR
