JustinVerkade/KiCadLibraryProcessor/SamacSysLibs/JVER_Models/PESD2USB3UVT-QR.stp

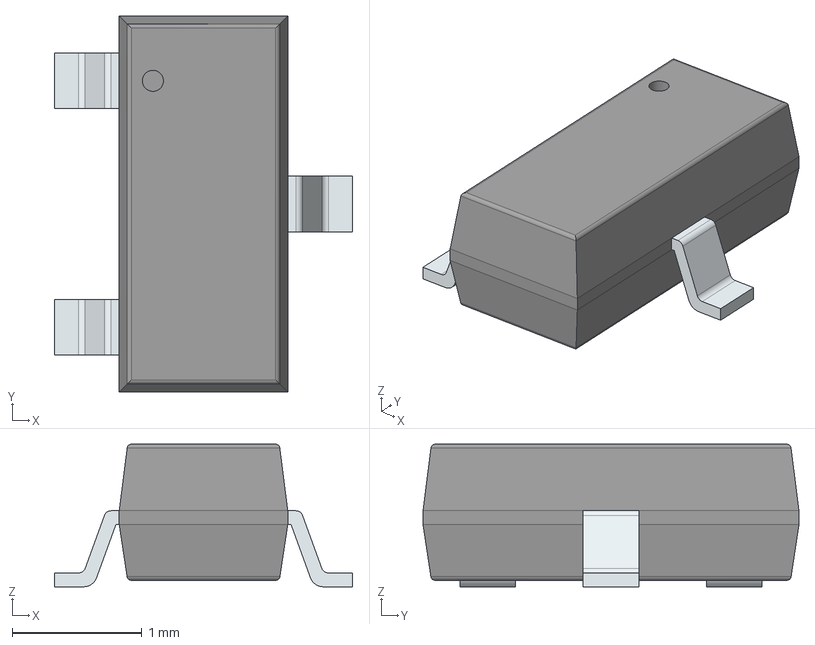
[picture p40: CAD file, 2025-02-11]
SamacSysLibs/JVER_Models/PESD2USB3UVT-QR.stp
2.30 x 2.90 x 1.10 mm
PinsArrayL
FilletPinR
