JustinVerkade/KiCadLibraryProcessor/SamacSysLibs/JVER_Models/AT24CSW040-STUM-T.stp

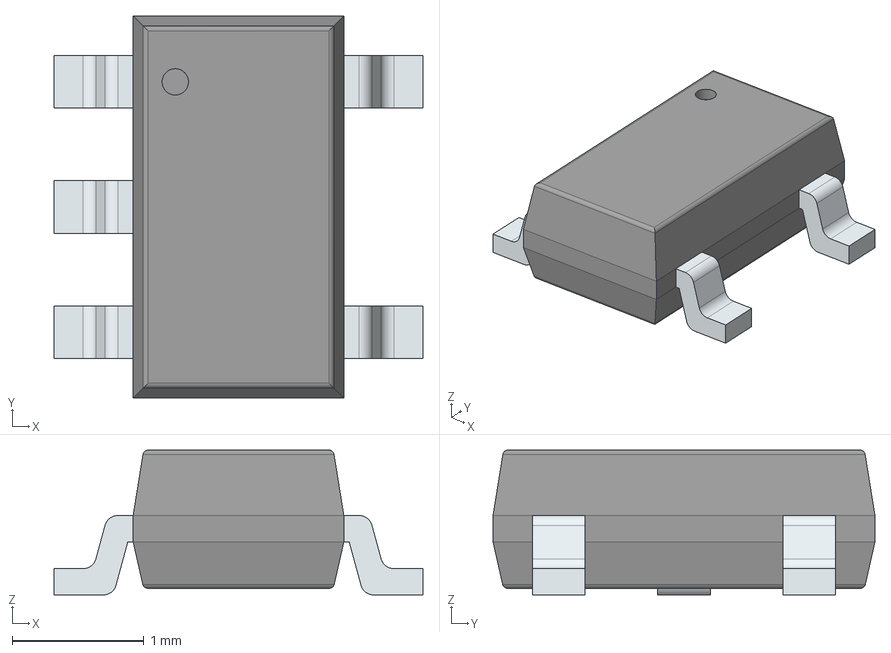
[picture p41: CAD file, 2025-02-11]
SamacSysLibs/JVER_Models/AT24CSW040-STUM-T.stp
2.80 x 2.90 x 1.10 mm
PinsArrayL
PinsArrayR
