JustinVerkade/KiCadLibraryProcessor/SamacSysLibs/JVER_Models/MLG1005S20NHT000.stp

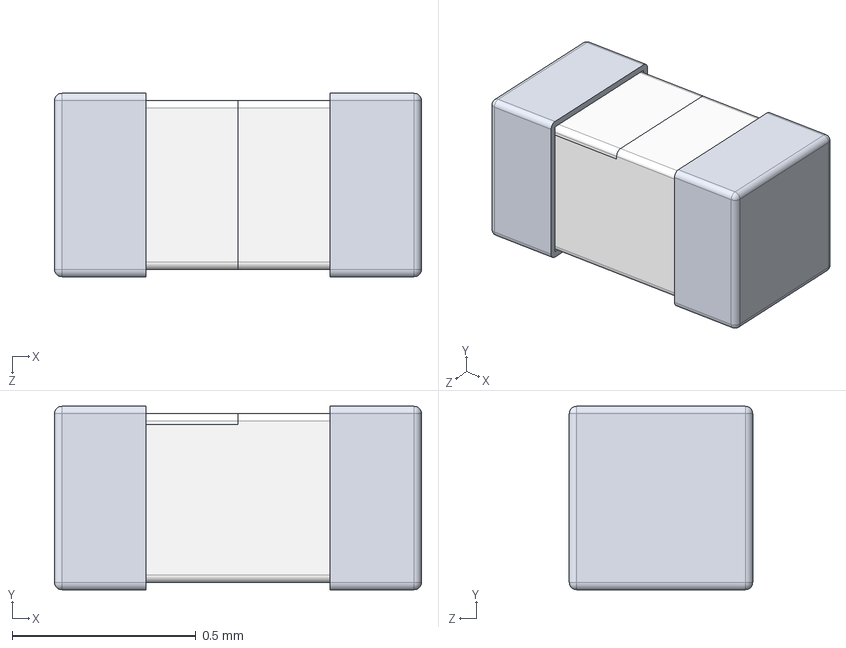
[picture p42: CAD file, 2025-02-11]
SamacSysLibs/JVER_Models/MLG1005S20NHT000.stp
1.00 x 0.5 x 0.5 mm
