JustinVerkade/KiCadLibraryProcessor/SamacSysLibs/JVER_Models/STM32F446RET6.stp

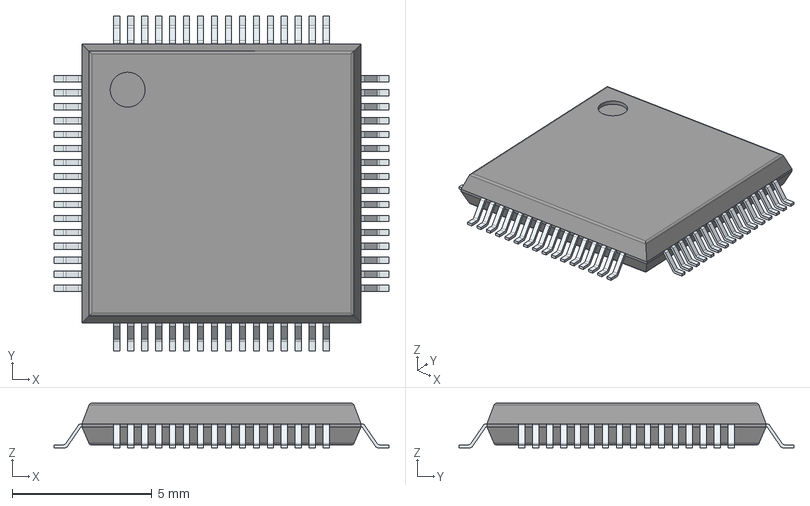
[picture p43: CAD file, 2025-02-11]
SamacSysLibs/JVER_Models/STM32F446RET6.stp
12.0 x 12.0 x 1.60 mm
PinsArrayLR
PinsArrayTB
