JustinVerkade/KiCadLibraryProcessor/SamacSysLibs/JVER_Models/CLY6D-FKC-CK1N1D1BB7D3D3.stp

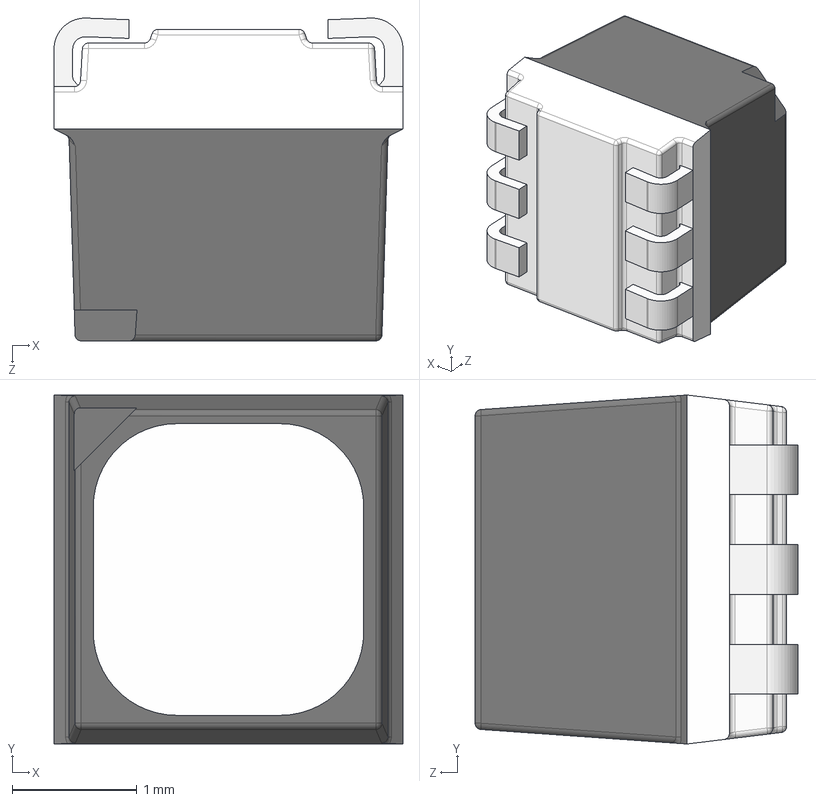
[picture p44: CAD file, 2025-02-11]
SamacSysLibs/JVER_Models/CLY6D-FKC-CK1N1D1BB7D3D3.stp
2.80 x 2.80 x 2.59 mm
bottom
pins1
pins2
main
glass
