JustinVerkade/KiCadLibraryProcessor/SamacSysLibs/JVER_Models/SNT-100-BK-G.stp

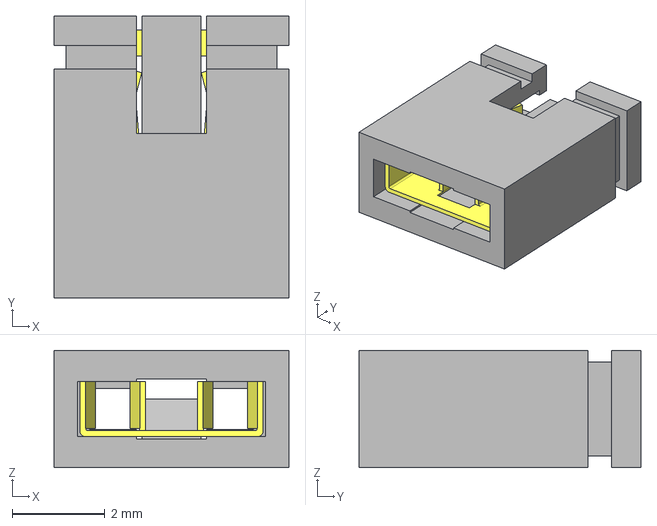
[picture p45: CAD file, 2025-02-11]
SamacSysLibs/JVER_Models/SNT-100-BK-G.stp
5.08 x 6.10 x 2.54 mm
SNT-100_pins
SNT-100-BK_body
