JustinVerkade/KiCadLibraryProcessor/SamacSysLibs/JVER_Models/UJ2-BH-W1-TH.stp

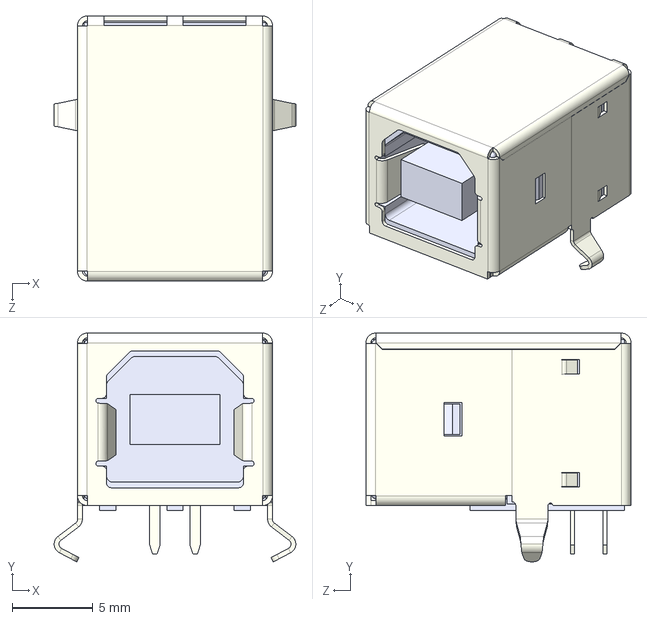
[picture p46: CAD file, 2025-02-11]
SamacSysLibs/JVER_Models/UJ2-BH-W1-TH.stp
15.0 x 14.2 x 16.5 mm
