JustinVerkade/KiCadLibraryProcessor/SamacSysLibs/JVER_Models/TSW-102-06-T-S.stp

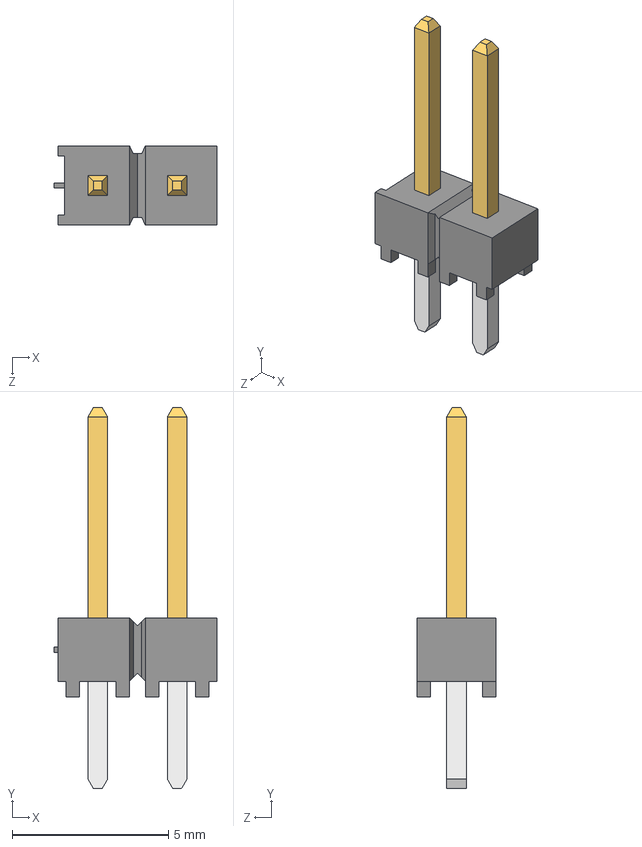
[picture p47: CAD file, 2025-02-11]
SamacSysLibs/JVER_Models/TSW-102-06-T-S.stp
5.21 x 12.2 x 2.54 mm
T-1S6-17-TSW-1-24-2-S
TSW-102-24-L-S_body
