JustinVerkade/KiCadLibraryProcessor/SamacSysLibs/JVER_Models/SRF4532-110Y.stp

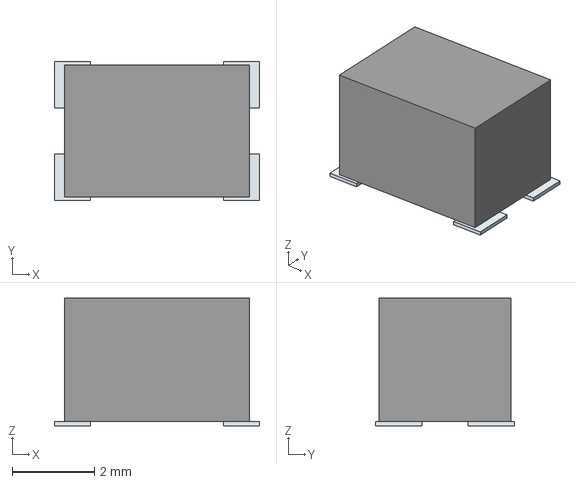
[picture p48: CAD file, 2025-02-11]
SamacSysLibs/JVER_Models/SRF4532-110Y.stp
4.98 x 3.38 x 3.10 mm
Pins
