JustinVerkade/KiCadLibraryProcessor/SamacSysLibs/JVER_Models/ATA6561-GAQW-N.stp

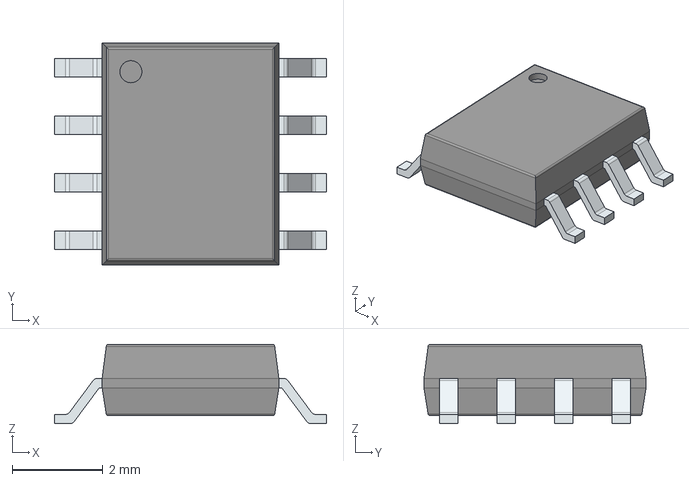
[picture p49: CAD file, 2025-02-11]
SamacSysLibs/JVER_Models/ATA6561-GAQW-N.stp
6.00 x 4.90 x 1.75 mm
PinsArrayLR
