JustinVerkade/KiCadLibraryProcessor/SamacSysLibs/JVER_Models/B3B-PH-K-S_LF__SN_.stp

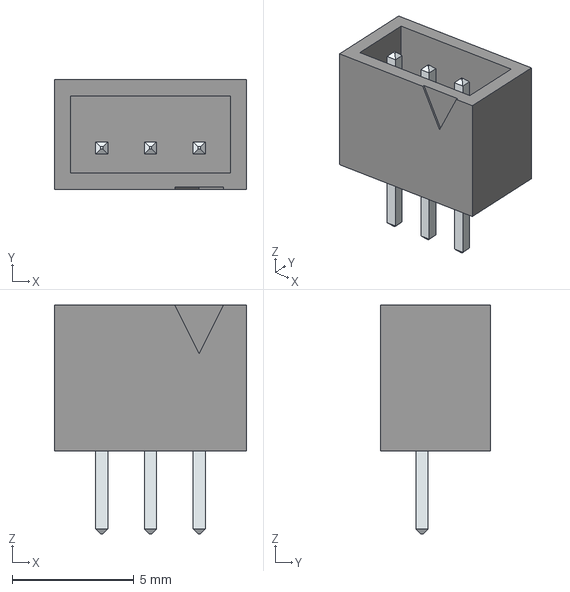
[picture p50: CAD file, 2025-02-11]
SamacSysLibs/JVER_Models/B3B-PH-K-S_LF__SN_.stp
7.90 x 4.50 x 9.40 mm
LeadsArray
