JustinVerkade/KiCadLibraryProcessor/SamacSysLibs/JVER_Models/XT60f.stp

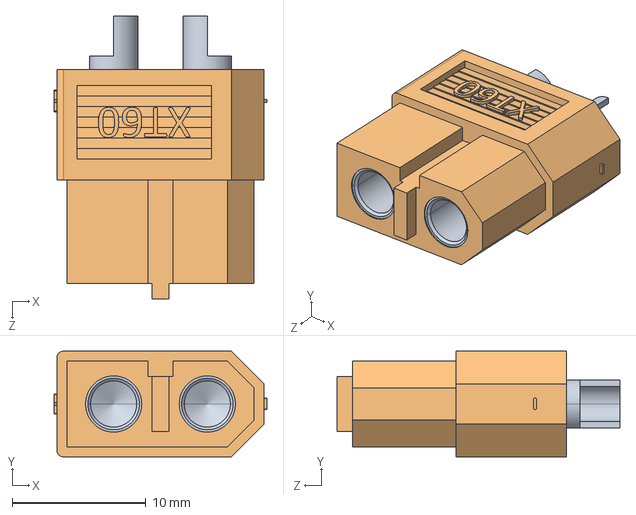
[picture p51: CAD file, 2025-02-09]
SamacSysLibs/JVER_Models/XT60f.stp
15.9 x 7.90 x 21.1 mm
