JustinVerkade/KiCadLibraryProcessor/SamacSysLibs/JVER_Models/SF-1206HH20M-2.stp

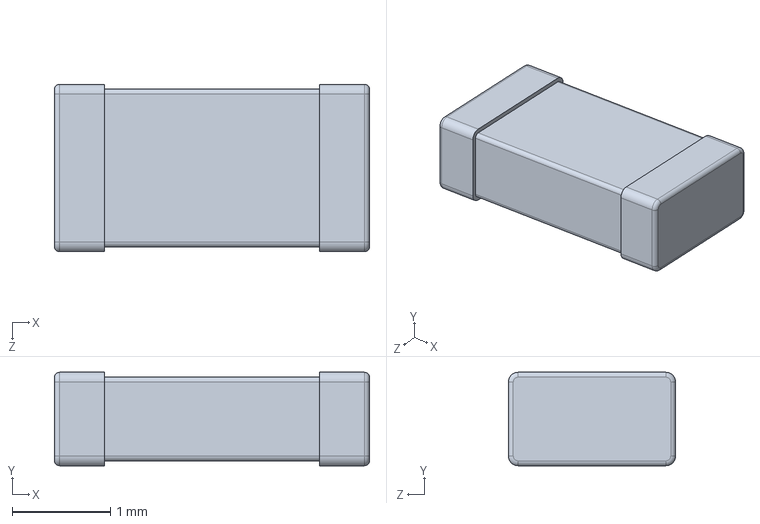
[picture p52: CAD file, 2025-02-09]
SamacSysLibs/JVER_Models/SF-1206HH20M-2.stp
3.20 x 0.95 x 1.70 mm
