JustinVerkade/KiCadLibraryProcessor/SamacSysLibs/JVER_Models/EEV227M016S9MAA.stp

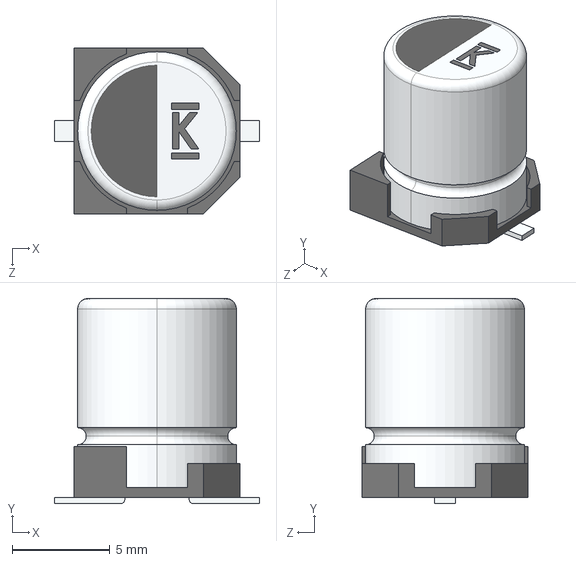
[picture p53: CAD file, 2025-02-08]
SamacSysLibs/JVER_Models/EEV227M016S9MAA.stp
10.5 x 10.5 x 8.50 mm
