JustinVerkade/KiCadLibraryProcessor/SamacSysLibs/JVER_Models/SRN6045-2R2Y.stp

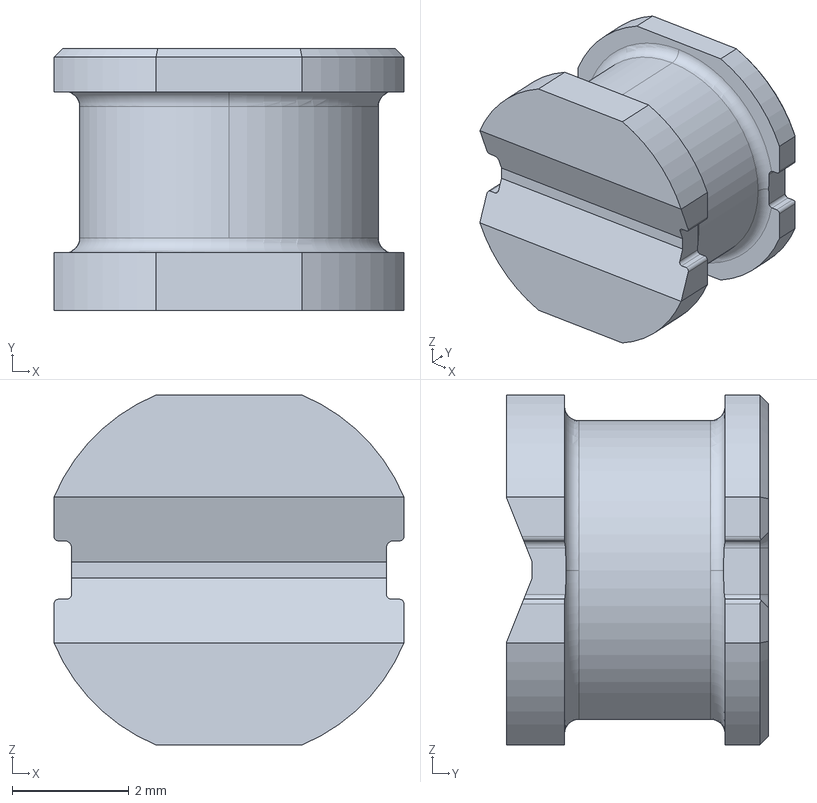
[picture p54: CAD file, 2025-02-08]
SamacSysLibs/JVER_Models/SRN6045-2R2Y.stp
6.00 x 4.50 x 6.00 mm
