JustinVerkade/KiCadLibraryProcessor/SamacSysLibs/JVER_Models/SRP7028CC-100M.stp

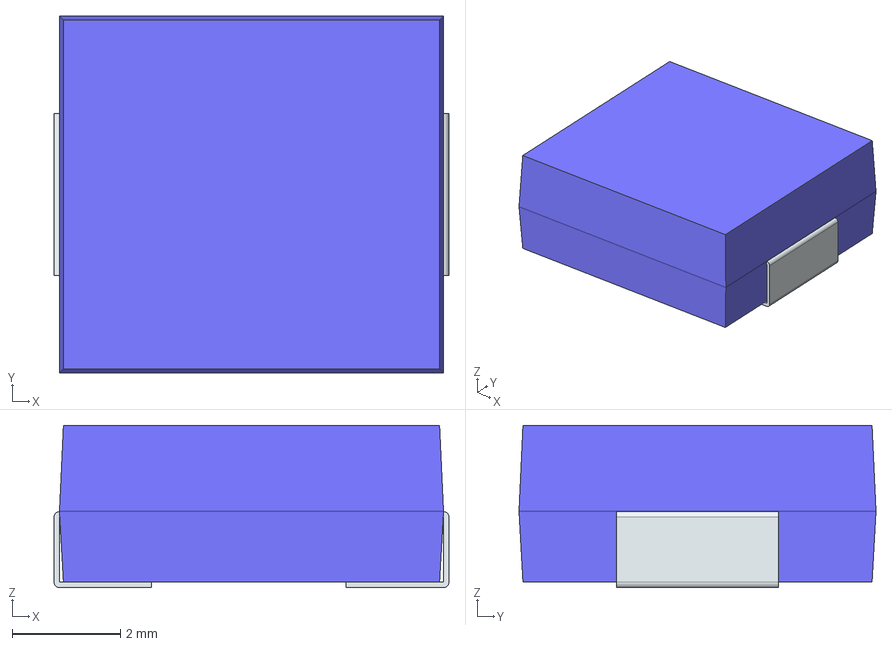
[picture p55: CAD file, 2025-02-08]
SamacSysLibs/JVER_Models/SRP7028CC-100M.stp
7.30 x 6.60 x 3.00 mm
FilletPin1
FilletPin2
