JustinVerkade/KiCadLibraryProcessor/SamacSysLibs/JVER_Models/SMAJ6.0A-13-F.stp

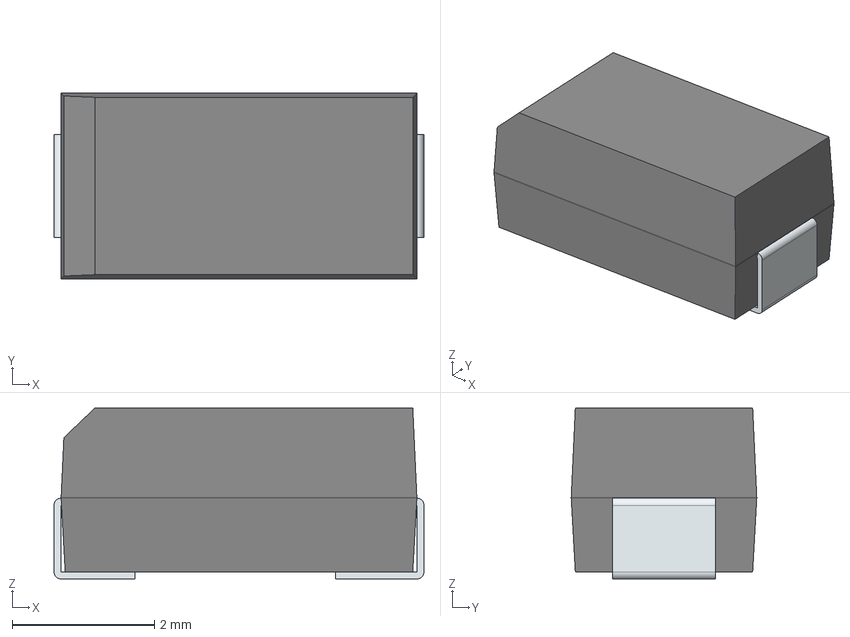
[picture p56: CAD file, 2025-02-08]
SamacSysLibs/JVER_Models/SMAJ6.0A-13-F.stp
5.20 x 2.60 x 2.40 mm
FilletPin1
FilletPin2
