JustinVerkade/KiCadLibraryProcessor/SamacSysLibs/JVER_Models/RT6274CHGJ6F.stp

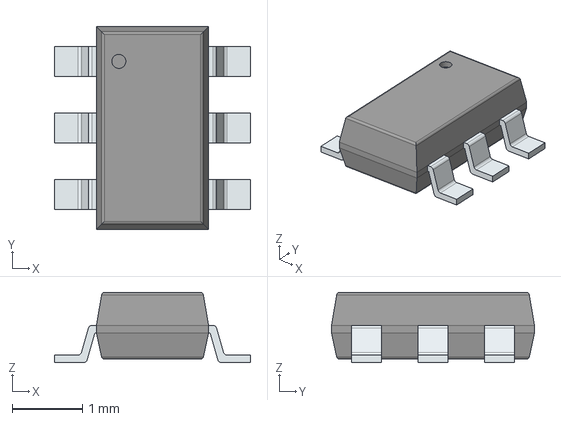
[picture p57: CAD file, 2025-02-08]
SamacSysLibs/JVER_Models/RT6274CHGJ6F.stp
2.80 x 2.90 x 1.00 mm
PinsArrayLR
