JustinVerkade/KiCadLibraryProcessor/SamacSysLibs/JVER_Models/ESDA18-1K.stp

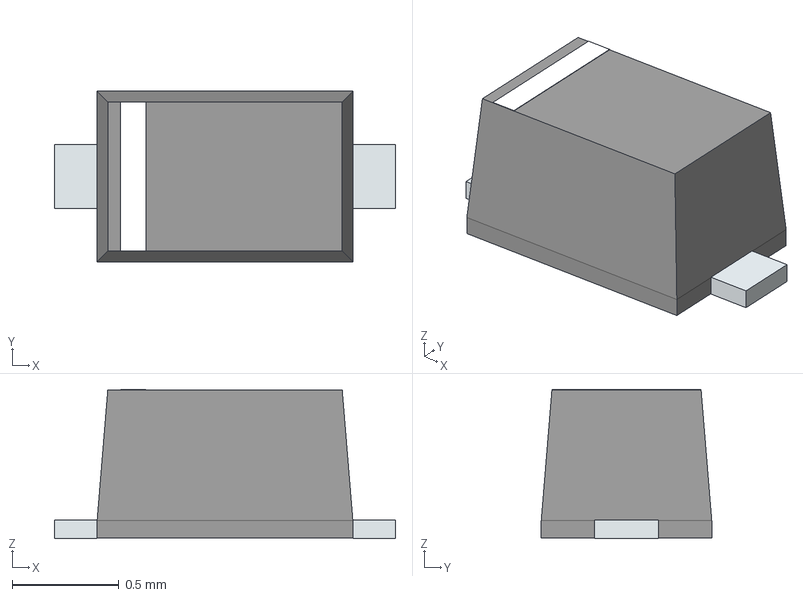
[picture p58: CAD file, 2025-02-08]
SamacSysLibs/JVER_Models/ESDA18-1K.stp
1.60 x 0.8 x 0.7 mm
PinKIdent
PinK
PinA
