JustinVerkade/KiCadLibraryProcessor/SamacSysLibs/JVER_Models/S2B-PH-SM4-TB_LF__SN_.stp

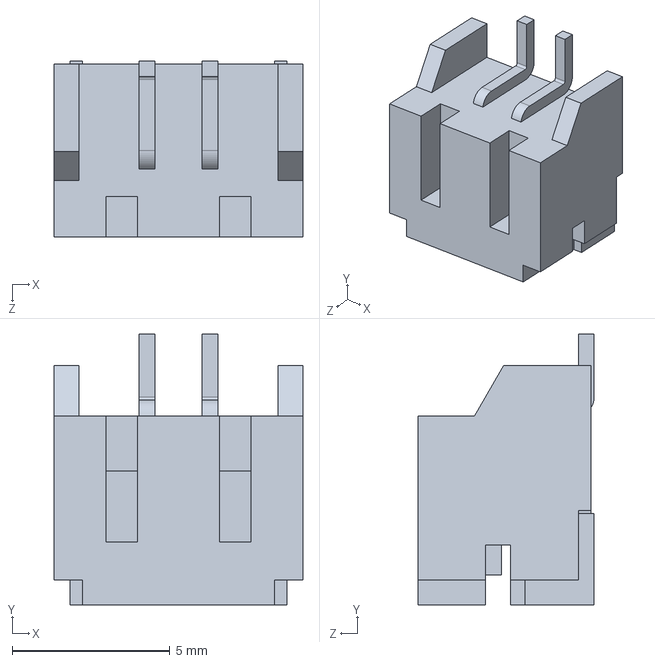
[picture p59: CAD file, 2025-02-08]
SamacSysLibs/JVER_Models/S2B-PH-SM4-TB_LF__SN_.stp
7.90 x 8.60 x 5.60 mm
