JustinVerkade/KiCadLibraryProcessor/SamacSysLibs/JVER_Models/ERB-RE2R00V.stp

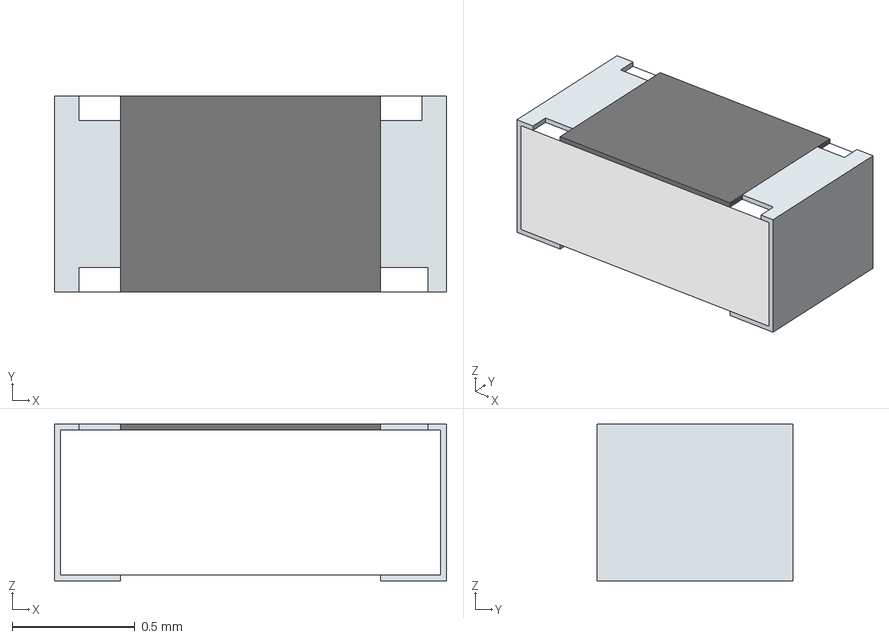
[picture p60: CAD file, 2025-02-08]
SamacSysLibs/JVER_Models/ERB-RE2R00V.stp
1.60 x 0.8 x 0.64 mm
solidBody
Terminal
solidTop
