JustinVerkade/KiCadLibraryProcessor/SamacSysLibs/JVER_Models/SRR5228A-100M.stp

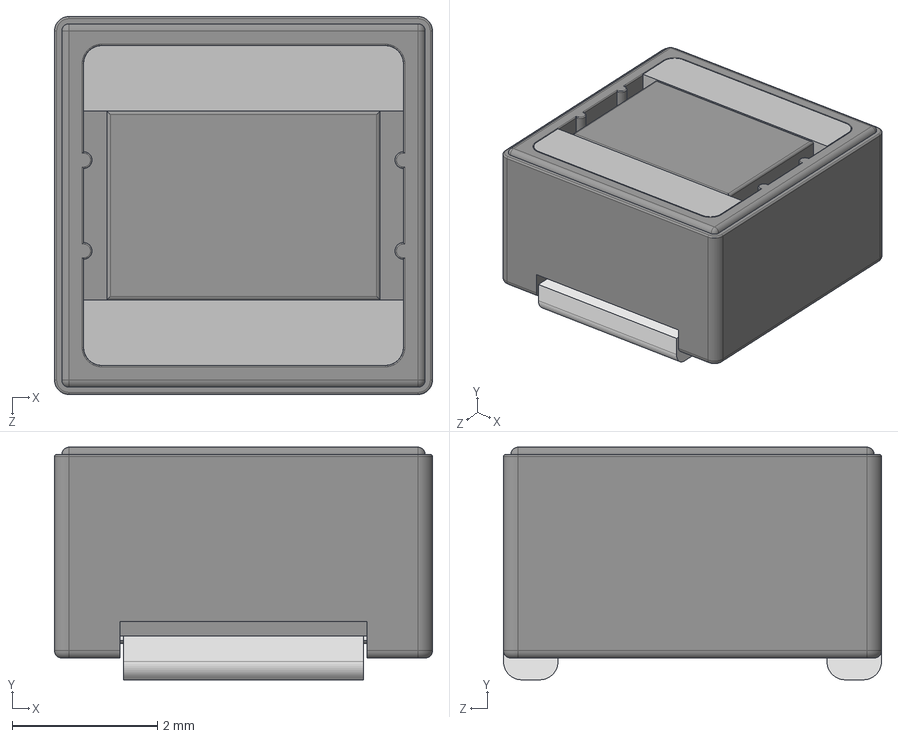
[picture p61: CAD file, 2025-02-08]
SamacSysLibs/JVER_Models/SRR5228A-100M.stp
5.20 x 3.20 x 5.20 mm
