JustinVerkade/KiCadLibraryProcessor/SamacSysLibs/JVER_Models/XT60.stp

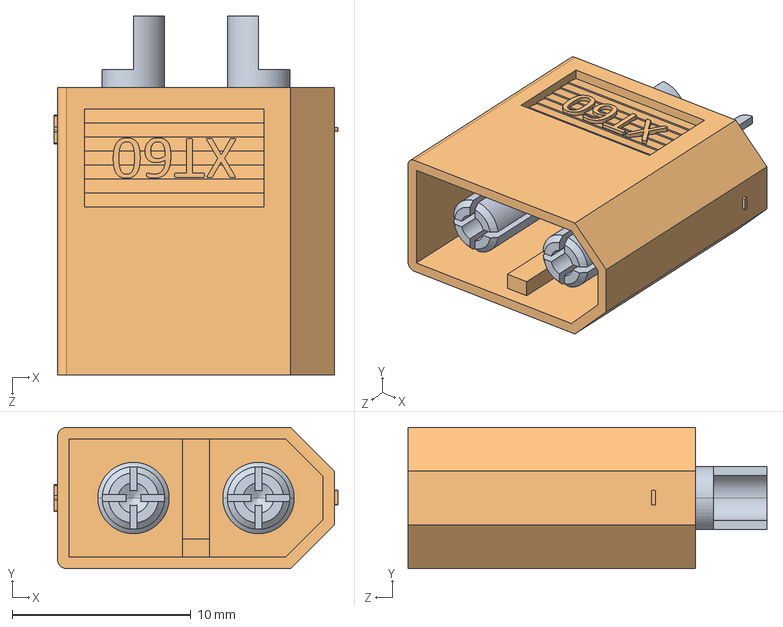
[picture p62: CAD file, 2025-02-08]
SamacSysLibs/JVER_Models/XT60.stp
15.9 x 7.90 x 20.1 mm
