JustinVerkade/KiCadLibraryProcessor/(list of files, cad)

Other CAD files:
SamacSysLibs/JVER_Models/IS66WVE4M16EBLL-70BLI-TR.stp
SamacSysLibs/JVER_Models/IS67WVE4M16EBLL-70BLA1.stp
SamacSysLibs/JVER_Models/ESD5Z3.3T5G.stp
SamacSysLibs/JVER_Models/0407006.WR.stp
SamacSysLibs/JVER_Models/0679L8000-05.stp
SamacSysLibs/JVER_Models/1206L075_16WR.stp
SamacSysLibs/JVER_Models/150060AS75000.stp
SamacSysLibs/JVER_Models/150060GS75000.stp
SamacSysLibs/JVER_Models/150060GS83000.stp
SamacSysLibs/JVER_Models/1707865.stp
SamacSysLibs/JVER_Models/67996-100HLF.stp
SamacSysLibs/JVER_Models/865080442004.stp
SamacSysLibs/JVER_Models/865090449009.stp
SamacSysLibs/JVER_Models/951103-8622-AR.stp
SamacSysLibs/JVER_Models/B82464G4472M.stp
SamacSysLibs/JVER_Models/LMR50410Y5FQDBVRQ1.stp
SamacSysLibs/JVER_Models/M20-7832046.stp
SamacSysLibs/JVER_Models/M20-9990645.stp
SamacSysLibs/JVER_Models/NSS30101LT1G.stp
