JustinVerkade/KiCadLibraryProcessor/(commit log)

2024-03-23 First version
    [2024-03-23-FoxConnect BOM.xlsx, 2024-03-23-TMC6300_HAL BOM.xlsx, 20240322-Electrical component library.xlsx, FoxConnect.csv, TMC6300_HAL.csv]
2024-03-23 Updated library document
    [2024-03-23-FoxConnect BOM.xlsx, 2024-03-23-TMC6300_HAL BOM.xlsx, 20240322-Electrical component library.xlsx, FoxConnect.csv]
2024-03-23 Library update
    [FoxConnect.csv, TMC6300_HAL.csv]
2024-11-14 push to github
    [FoxConnect.csv]
2024-12-20 Added linux library loader
    [2024-03-23-FoxConnect BOM.xlsx, 20240322-Electrical component library.xlsx, ATMEGA3208-MUR.stp, FoxConnect.csv, STM32G050C8T6.stp]
2025-02-09 Power distribution board
    [0407006.WR.stp, SF-1206HH20M-2.stp, XT60f.stp]
2025-02-11 Added components
    [150060AS75000.stp, 150060GS75000.stp, AT24CSW040-STUM-T.stp, ATA6561-GAQW-N.stp, B3B-PH-K-S_LF__SN_.stp, BWCU00321619102M02.stp, CLY6D-FKC-CK1N1D1BB7D3D3.stp, DMN63D8L-7.stp]
2025-02-16 Added Vex components
    [2024-03-23-FoxConnect BOM.xlsx, 20240322-Electrical component library.xlsx, 865080442004.stp, BZT52C5V6-TP.stp, ECS-80-8-33B2Q-CVY-TR3.stp, FoxConnect.csv, IFSC1616AHER4R7M01.stp, LMR50410Y5FQDBVRQ1.stp]
2025-02-21 Added more parts
    [0679L8000-05.stp, 1707865.stp, 20240322-Electrical component library.xlsx, 39-30-6087.stp, CSNL1206FT20L0.stp, EEE-FT1H331AP.stp, IHLP3232DZER4R7M11.stp, LM321LVIDCKR.stp]
2025-02-21 Additional files
    [ESD5Z5.0T5G.stp, ESD9P5.0ST5G.stp, LM339BIPWR.stp, LM339LVPWR.stp, MLZ1608A2R2MT.stp]
2025-02-22 Added parts
    [20240322-Electrical component library.xlsx, SM15T15A.stp]
2025-03-03 Minor cleanup of code
    [20240322-Electrical component library.xlsx]
2025-03-11 PEP8 conformity
    [STM32C071GBU6.stp]
2025-08-14 Added Embedded_AoC parts
    [1206L075_16WR.stp, 150060GS83000.stp, 20240322-Electrical component library.xlsx, 67996-100HLF.stp, ADP2302ARDZ-3.3-R7.stp, AS6C6416-55TIN.stp, B82464G4472M.stp, ECS-160-12-30BQ-ADS-TR.stp]
