JustinVerkade/KiCadLibraryProcessor/(notices)

Notices in the files:
SamacSysLibs/JVER_Models/TST-110-01-F-D.stp:
author */ ('License CC BY-ND 4.0'),
